yunjasper/ecse478_honours_thesis/0 Documentation/1 Design Calculations/non-inverting amplifier gain tolerance calculations.png

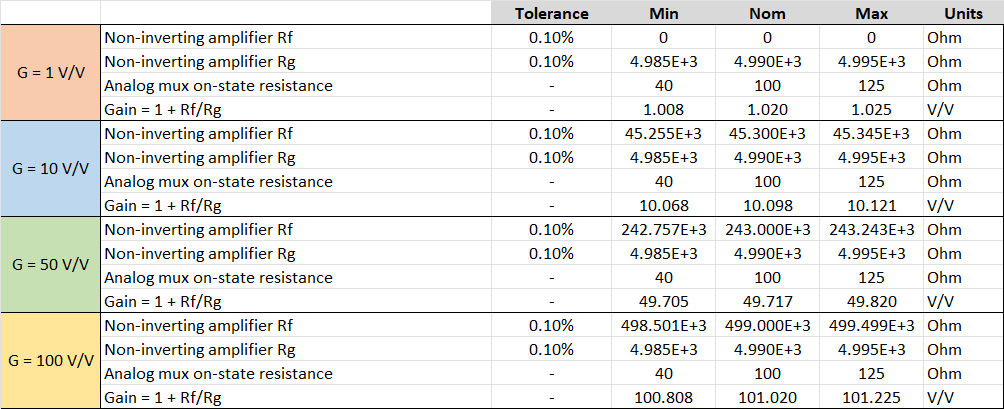
0 Documentation/1 Design Calculations/non-inverting amplifier gain tolerance calculations.png
