yunjasper/ecse478_honours_thesis/0 Documentation/2 Diagrams/Digital IO Protection.png

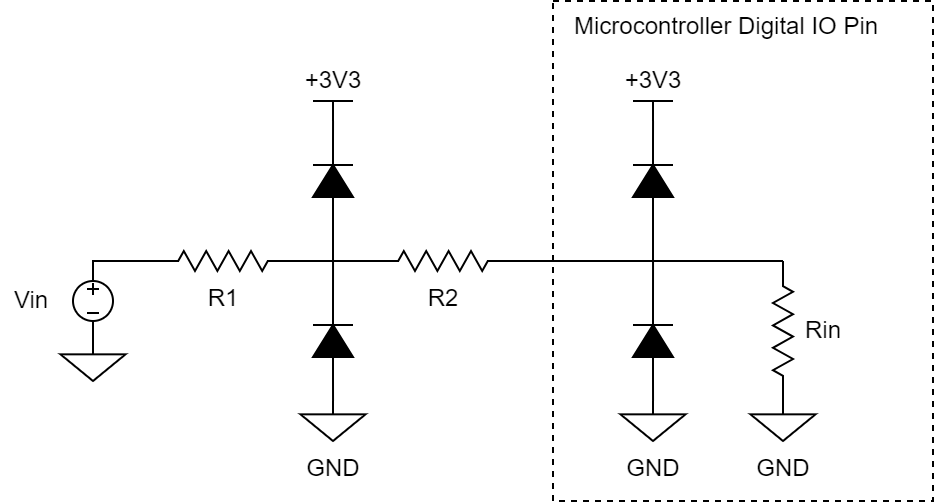
0 Documentation/2 Diagrams/Digital IO Protection.png
