yunjasper/ecse478_honours_thesis/0 Documentation/2 Diagrams/Main block diagram.png

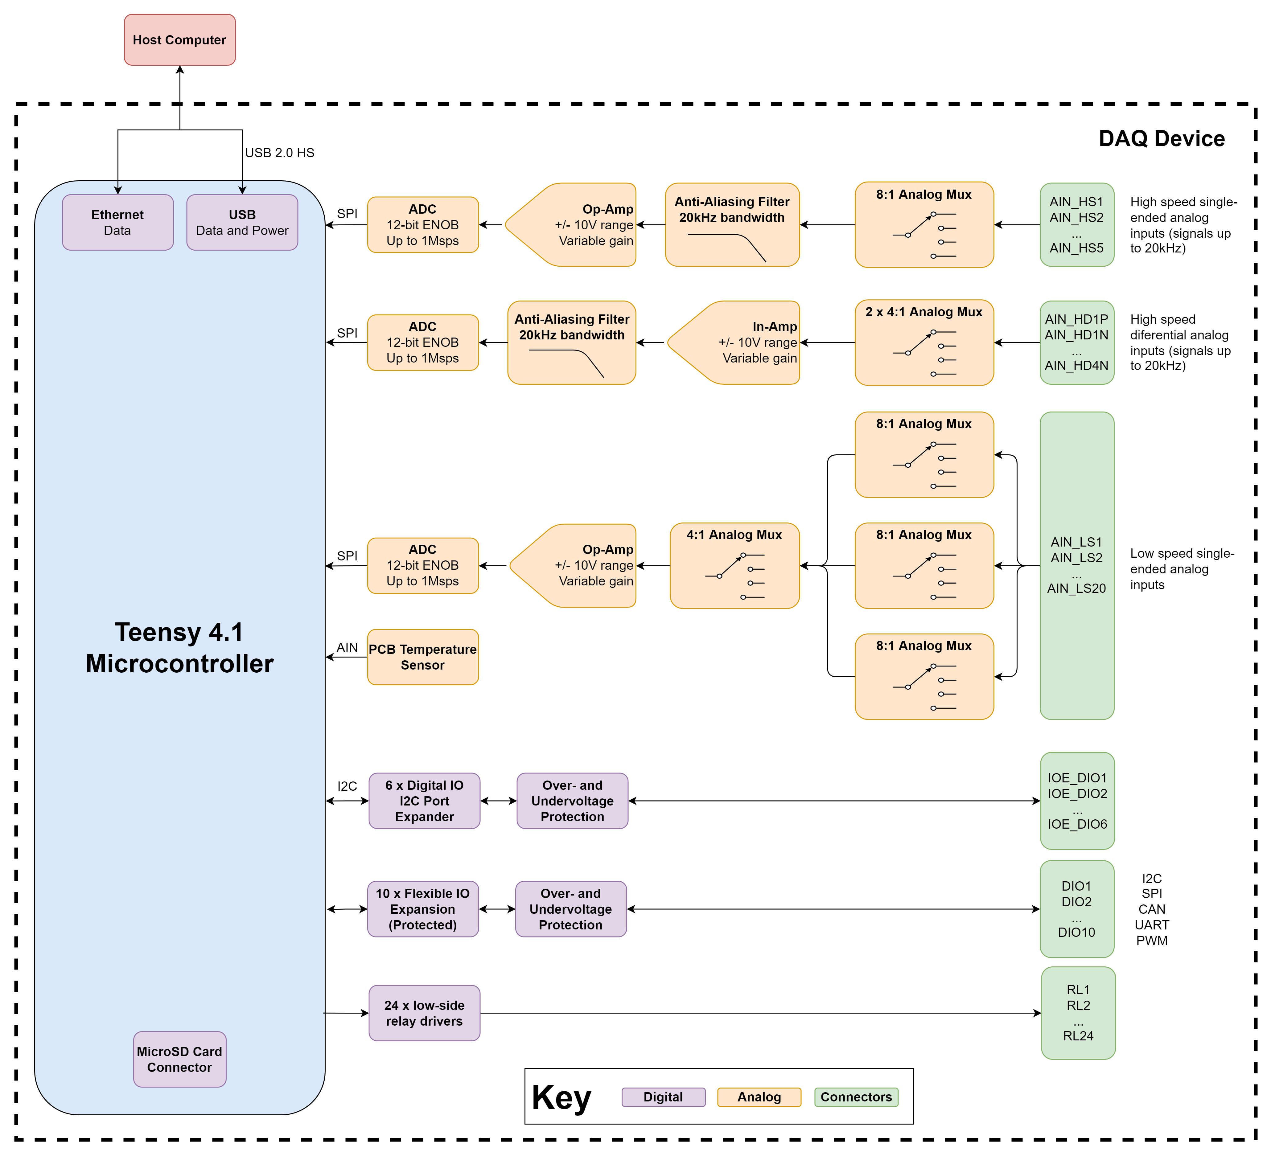
0 Documentation/2 Diagrams/Main block diagram.png
