yunjasper/ecse478_honours_thesis/0 Documentation/2 Diagrams/MCP33151 Eval Board Block Diagram.png

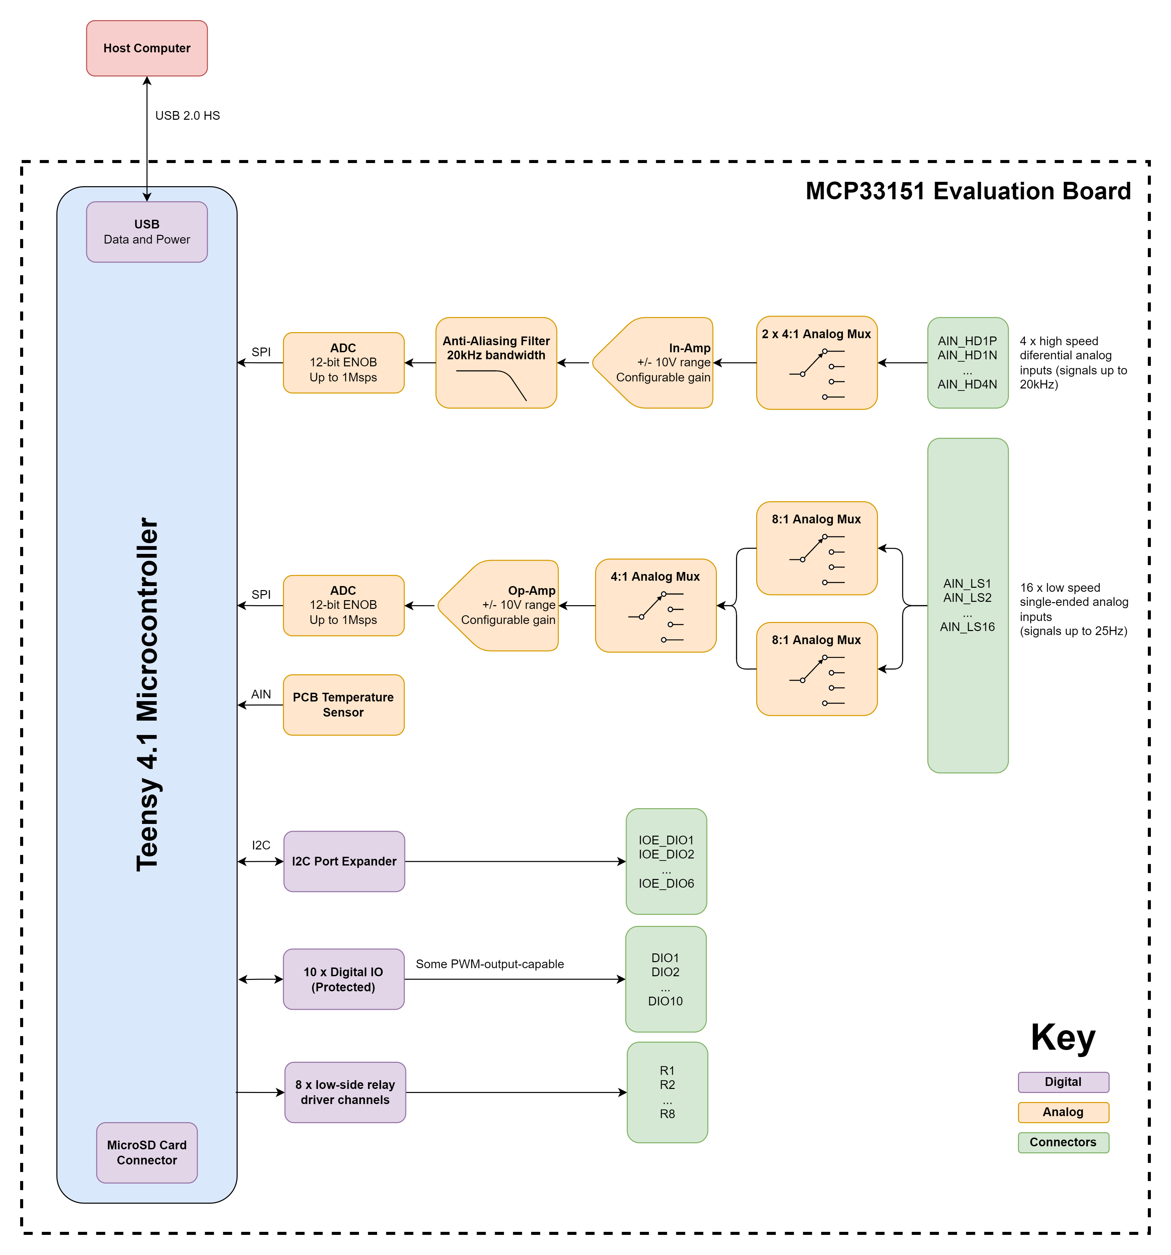
0 Documentation/2 Diagrams/MCP33151 Eval Board Block Diagram.png
