yunjasper/ecse478_honours_thesis/0 Documentation/2 Diagrams/Non-Inv Amp Gain Tolerances.png

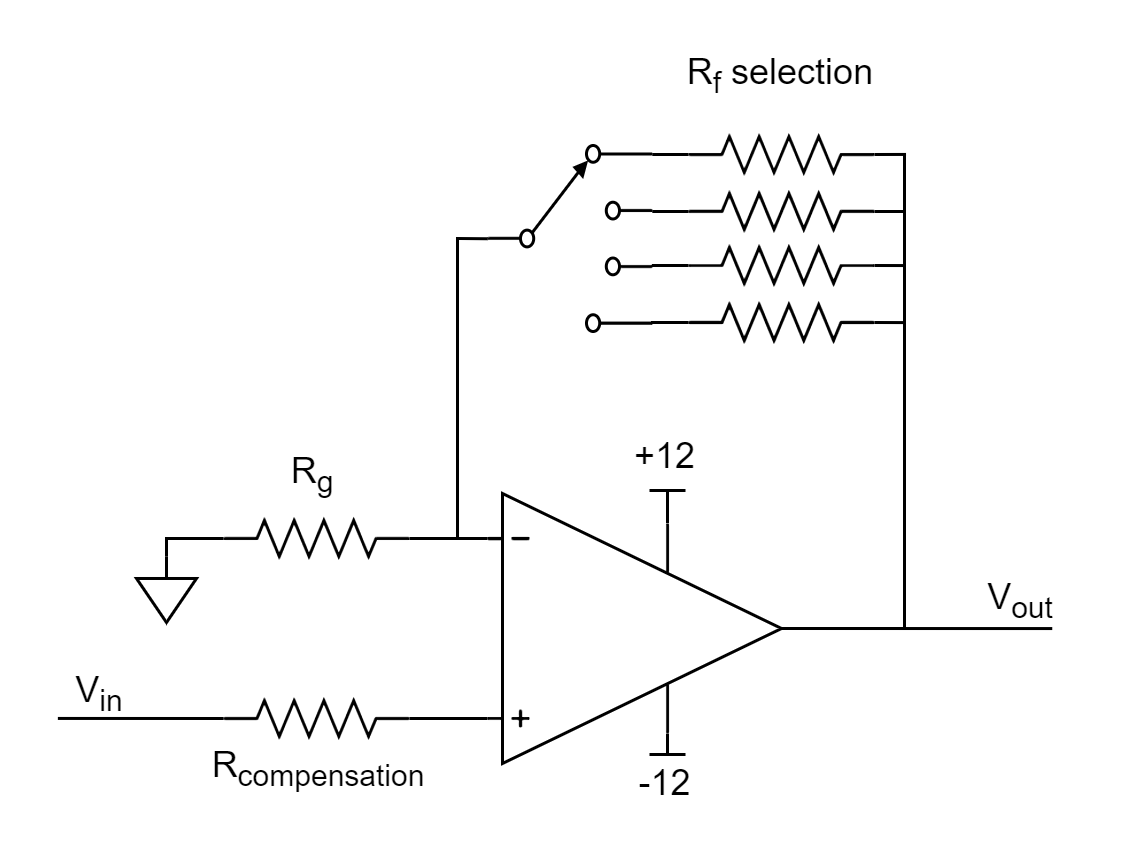
0 Documentation/2 Diagrams/Non-Inv Amp Gain Tolerances.png
