yunjasper/ecse478_honours_thesis/0 Documentation/2 Diagrams/Power Architecture.png

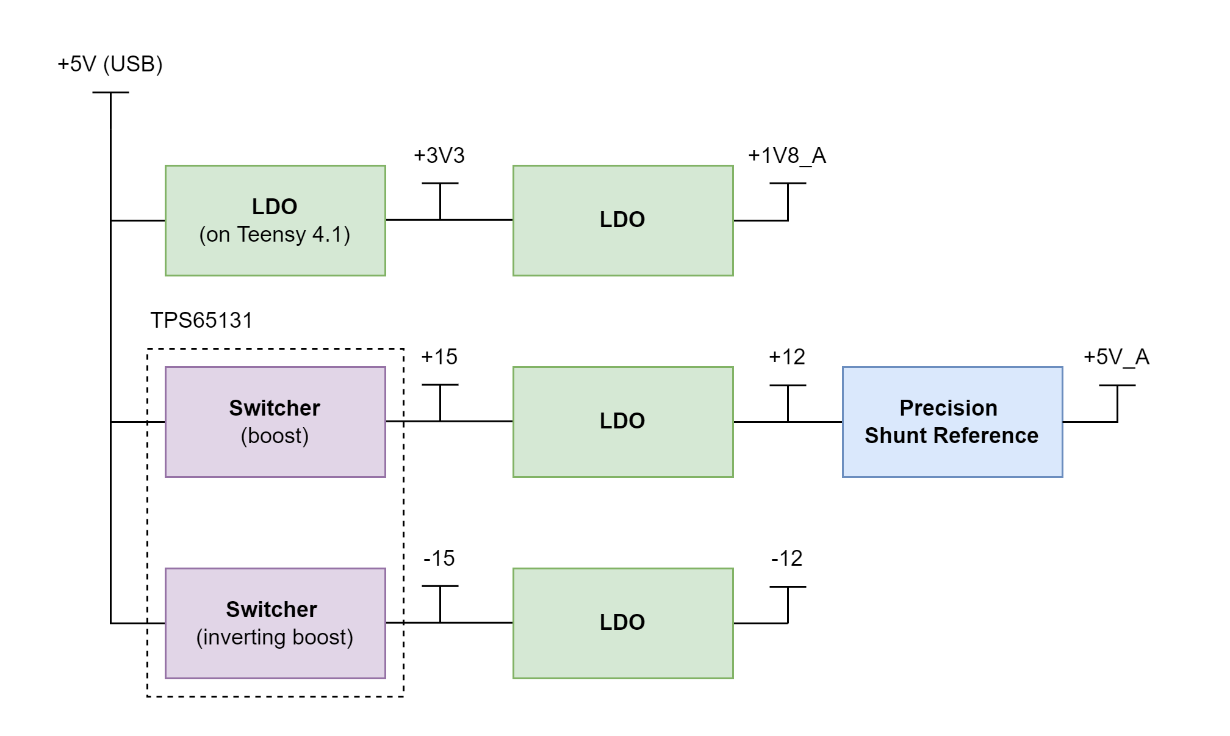
0 Documentation/2 Diagrams/Power Architecture.png
