yunjasper/ecse478_honours_thesis/0 Documentation/2 Diagrams/sampling and anti-aliasing.png

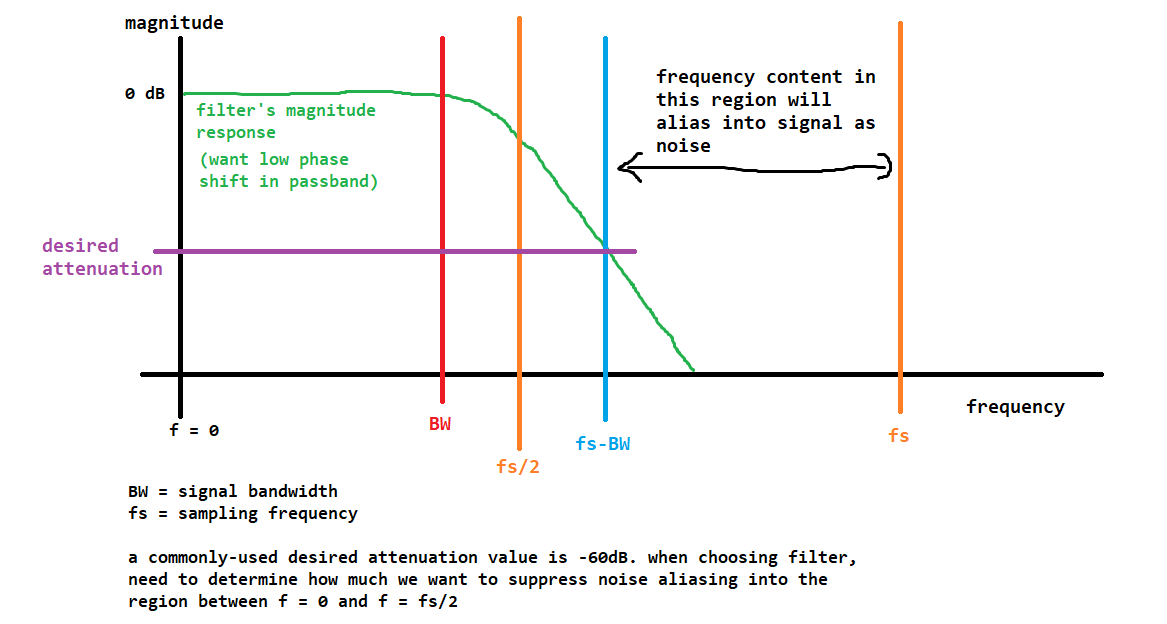
0 Documentation/2 Diagrams/sampling and anti-aliasing.png
