yunjasper/ecse478_honours_thesis/0 Documentation/2 Diagrams/sampling and anti-aliasing_original.png

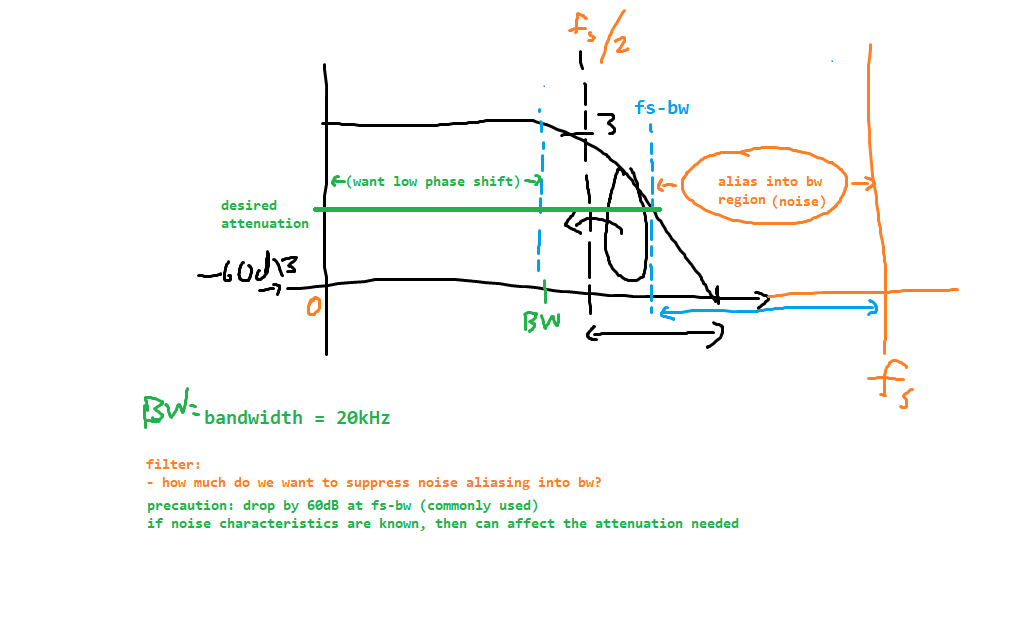
0 Documentation/2 Diagrams/sampling and anti-aliasing_original.png
