yunjasper/ecse478_honours_thesis/1 Hardware/MCP33151 Eval Board/Project Outputs for MCP33151 Eval Board/BOM - MCP33151 Eval Board.xlsx

Name | Description | Designator | Manufacturer Part Number 1 | Quantity (Single Board) | Quantity (3 boards)
10nF | Capacitor | C1, C17, C21 |  | 3 | 9
100nF | Capacitor | C2, C8, C11, C14, C15, C18, C24, C26, C27, C29, C30, C31, C32, C33, C34, C37, C38, C40, C41, C48, C49, C50, C51, C52, C53, C54, C55, C56, C57, C58, C59, C60, C61, C62, C63, C64, C65, C68, C69, C73, C74, C76, C77 |  | 43 | 129
47uF | Capacitor | C3, C4, C6, C19, C20, C78, C79 |  | 7 | 21
13pF | Capacitor | C5, C12 |  | 2 | 6
10uF | Capacitor | C7, C10, C13, C16, C66, C67, C70, C71, C72, C75 |  | 10 | 30
220nF | Capacitor | C9 |  | 1 | 3
4.7nF | Capacitor | C22 |  | 1 | 3
10uF | Capacitor | C23, C25, C28 |  | 3 | 9
100pF | Capacitor | C35, C39, C45, C46, C47 |  | 5 | 15
1nF | Capacitor | C36, C42, C43, C44 |  | 4 | 12
BAT54S | Rectifier Diode Small Signal Schottky 40V 0.3A 5ns 3-Pin SOT-23 T/R | D1, D2, D3, D4, D5, D6, D7, D8, D9, D10, D13, D14, D15, D16, D17, D18, D19, D20 | BAT54SFILM | 18 | 54
CDBA140-HF | Generic Schottky Diode | D11, D12 |  | 2 | 6
LED Green | Generic Green LED | D21, D22, D23, D24, D25, D26, D27, D29, D30 |  | 9 | 27
LED Red | Generic Red LED | D28 |  | 1 | 3
4.7uH | 4.7uH BWVS005050404R7M00 | L1, L2 |  | 2 | 6
1985195 | Header, 2-Pin | P1, P2, P3, P4, P5, P6, P7, P8, P9, P10, P11, P12, P13, P14, P15, P16, P17, P18, P19, P20, P21, P22, P23, P24, P25, P26, P27, P28, P29, P30, P34, P35, P36, P37 |  | 34 | 102
Jumper | Header, 2-Pin | P32, P33 |  | 2 | 6
AO3407A | AO3407A PMOS | Q1 |  | 1 | 3
470R |  | R1, R2, R5, R6, R9, R10, R13, R14, R17, R18, R33, R34, R37, R39, R41, R43 |  | 16 | 48
10R |  | R3, R4, R7, R8, R11, R12, R15, R16, R19, R20, R35, R36, R38, R40, R42, R44 |  | 16 | 48
10K0 | Resistor | R21, R27 |  | 2 | 6
536K0 | Resistor | R22 |  | 1 | 3
47K50 | Resistor | R23, R24 |  | 2 | 6
100R | Resistor | R25 |  | 1 | 3
576K00 | Resistor | R26 |  | 1 | 3
4K22 | Resistor | R28 |  | 1 | 3
33R | Resistor | R29, R101, R102, R103, R104, R105, R106 |  | 7 | 21
2K55 | Resistor | R30, R31, R77, R78, R79, R80 |  | 6 | 18
10K0 | Resistor | R32, R66, R67, R68, R69, R70, R91 |  | 7 | 21
0R | Resistor | R45, R47, R56, R61, R87, R88, R89, R90, R92 |  | 9 | 27
1K00 | Resistor | R46 |  | 1 | 3
47K5 | Resistor | R48, R49 |  | 2 | 6
63K40 | Resistor | R50 |  | 1 | 3
1K69 | Resistor | R51 |  | 1 | 3
48K70 | Resistor | R52 |  | 1 | 3
1K96 | Resistor | R53 |  | 1 | 3
24K30 | Resistor | R54 |  | 1 | 3
3K16 | Resistor | R55 |  | 1 | 3
4K99 | Resistor | R57, R62 |  | 2 | 6
45K30 | Resistor | R58, R63 |  | 2 | 6
243K00 | Resistor | R59, R64 |  | 2 | 6
499K00 | Resistor | R60, R65 |  | 2 | 6
10K0 | Resistor | R71, R72, R73, R74 |  | 4 | 12
4K70 | Resistor | R75, R76 |  | 2 | 6
200R | Resistor | R81 |  | 1 | 3
15R | Resistor | R82, R83 |  | 2 | 6
0R | Resistor | R84 |  | 1 | 3
4K53 | Resistor | R85, R86 |  | 2 | 6
Test Point | Keystone 5015 Test point | TP1, TP8, TP9, TP10, TP12, TP14, TP15, TP17, TP18, TP22, TP23, TP25, TP26, TP31, TP32, TP33, TP34, TP37, TP38 |  | 19 | 57
NUD3160DMT1G | IC INDCT LOAD DRVR INDUST SC74-6 | U1, U2, U3, U4 | NUD3160DMT1G | 4 | 12
TPS65131RGER | IC REG BUCK BST INV ADJ DL 24QFN | U5 | TPS65131RGER | 1 | 3
TLV74118PDBVR | None | U6 | TLV74118PDBVR | 1 | 3
ADR5045BRTZ-REEL7 | Precision Micropower Shunt Mode Voltage Reference, 5 V Output, Industrial, 3-pin SOT23 (RT-3), Reel | U7 | ADR5045BRTZ-REEL7 | 1 | 3
MC79L12ACDR | Fixed Regulator with -14.5 to -27 V Input and -12 V Output, 0 to 125 degC, 8-Pin SOIC (D), Green (RoHS & no Sb/Br) | U8 | MC79L12ACDR | 1 | 3
TLV76012DBZR | IC REG LINEAR 12V 100MA SOT23-3 | U9 | TLV76012DBZR | 1 | 3
Teensy 4.1 | Teensy 4.1 breakout (no ethernet or USB host pins exposed) | U10 |  | 1 | 3
MCP23008-E/ML | 8-Bit I/O Expander with Serial Interface, 20-Pin QFN, Extended Temperature | U11, U12 | MCP23008-E/ML | 2 | 6
INA821IDR | IC INST AMP 1 CIRCUIT 8SOIC | U13 | INA821IDR | 1 | 3
DG409DQ-E3 | DG409 Series 20 V 8-Ch/Dual 4-Ch High-Performance CMOS Analog Multiplexer | U14, U18, U20, U23 | DG409DQ-E3 | 4 | 12
RC4580 | 2-channel, 12-MHz, low-noise, low-distortion audio op amp with high output current 8-SOIC -40 to 85 | U15, U16, U17, U21 | RC4580IDR | 4 | 12
DG408DQ-T1-E3 | DG408DQ-T1-E3; Multiplexer Single 8: 1; 15 V; 18 V; 24 V; 28 V; 16-Pin TSSOP | U19, U22 | DG408DQ-T1-E3 | 2 | 6
MCP33151-10-E/MS | ADC 14-bit SAR 1Msps 10-MSOP | U24, U25 | MCP33151-10-E/MS | 2 | 6
MCP9700T-E/TT | Low-Power Linear Active Thermistor IC, 3-Pin SOT-23, Extended Temperature, Tape and Reel | U26 | MCP9700T-E/TT | 1 | 3
