yunjasper/ecse478_honours_thesis/1 Hardware/ECSE478 - DAQ Device/Project Outputs for ECSE478 - DAQ Device/BOM/Bill of Materials-ECSE478 - DAQ Device.xlsx

Bill of Materials -- DAQ Device
Name | Description | Designator | Quantity | Footprint
TLV2172IDR | 2-channel, 12-MHz, low-noise, low-distortion audio op amp with high output current 8-SOIC -40 to 85 | U24, U26, U27, U31, U32, U33, U37, U44 | 8 | SOIC-8
4.7uH | 4.7uH BWVS005050404R7M00 | L1, L2 | 2 | Inductor BWVS005050403R3M00
MCP23008-E/ML | 8-Bit I/O Expander with Serial Interface, 20-Pin QFN, Extended Temperature | U20, U21, U22, U23 | 4 | QFN-ML20_M
LDK320AM120R | 200 mA low quiescent current and high PSRR voltage regulator | U17 | 1 | SOT23-5
MCP33151-10-E/MS | ADC 14-bit SAR 1Msps 10-MSOP | U41, U42, U43 | 3 | MSOP-10
D12V0L1B2LP-7B | Bidirectional Zener diode | D33, D34, D35, D36, D37, D38, D39, D40, D41, D42, D43, D44, D45, D46, D47, D48, D49, D50, D51, D52, D53, D54, D55, D56, D57, D58, D59, D60, D61, D62, D63, D64, D65, D66, D67, D68, D69, D70, D71, D72, D73, D74, D75, D76 | 44 | DFN1006-2
100nF | Capacitor | C1, C2, C9, C12, C15, C16, C18, C19, C26, C28, C29, C31, C32, C34, C35, C36, C37, C38, C39, C43, C47, C48, C49, C50, C51, C52, C53, C55, C56, C57, C60, C61, C63, C64, C71, C72, C73, C74, C75, C77, C78, C80, C81, C82, C83, C84, C85, C86, C87, C88, C89, C90, C93, C94, C96, C98, C99, C103, C104, C108, C110, C113, C114 | 63 | 0402 CAP
22uF | Capacitor | C3, C4, C5, C20, C21, C22 | 6 | 1206 CAP
13pF | Capacitor | C6, C13 | 2 | 0402 CAP
47uF | Capacitor | C7, C111, C112 | 3 | 0805 CAP
10uF | Capacitor | C8, C11, C14, C17, C91, C92, C95, C97, C100, C101, C102, C105, C109 | 13 | 0603 CAP SAMSUNG CL10C
220nF | Capacitor | C10 | 1 | 0402 CAP
10nF | Capacitor | C23 | 1 | 0402 CAP
4.7nF | Capacitor | C24 | 1 | 0402 CAP
10uF | Capacitor | C25, C27, C30, C106, C107 | 5 | 0805 CAP
1nF | Capacitor | C40, C41, C42, C65, C66, C67 | 6 | 0402 CAP
100pF | Capacitor | C44, C45, C46, C68, C69, C70 | 6 | 0402 CAP
SMT-0540-T-9-R | CMT-9648-85T Magnetic buzzer | LS1 | 1 | Buzzer SMT-0540-T-9-R
LD25S24A4GV00LF | DB25 LD25S24A4GV00LF (Amphenol ICC) | J2, J4 | 2 | Connector DB25 Vertical LD25S24A4GV00LF
LD37S24A4GV00LF | DB37 LD37S24A4GV00LF (Amphenol ICC) | J1, J3 | 2 | Connector DB37 Vertical LD37S24A4GV00LF
DG408DQ-T1-E3 | DG408DQ-T1-E3; Multiplexer Single 8: 1; 15 V; 18 V; 24 V; 28 V; 16-Pin TSSOP | U25, U35, U38, U40 | 4 | TSSOP-16
DG409DQ-E3 | DG409 Series 20 V 8-Ch/Dual 4-Ch High-Performance CMOS Analog Multiplexer | U28, U30, U34, U36, U39 | 5 | TSSOP-16
MC79L12ACDR | Fixed Regulator with -14.5 to -27 V Input and -12 V Output, 0 to 125 degC, 8-Pin SOIC (D), Green (RoHS & no Sb/Br) | U16 | 1 | D0008A_M
LED Green | Generic Green LED | D19, D20, D21, D22, D23, D25, D30, D31, D32 | 9 | 0603 LED
LED Red | Generic Red LED | D24 | 1 | 0603 LED
220R | Generic resistor | R124 | 1 | 0402 RES
CDBA140-HF | Generic Schottky Diode | D1, D2 | 2 | Diode SMA
B0540WSHE3-TP | Generic Schottky Diode | D29 | 1 | Diode SOD323-F
1985195 | Header, 2-Pin | P1, P2, P3, P4, P5, P6, P7, P8, P9, P10, P11, P12, P13, P14, P15, P16, P17, P18, P19, P20, P21, P22, P23, P24, P25, P26, P27, P28, P29, P30, P31, P32, P33, P34, P35, P36, P37, P38, P39, P40, P41, P42, P43, P44, P45, P46, P47, P48 | 48 | Terminal Block 1985195 2-pos 3.5mm pitch
Jumper | Header, 2-Pin | P49, P50, P51 | 3 | HDR1X2
NUD3160DMT1G | IC INDCT LOAD DRVR INDUST SC74-6 | U1, U2, U3, U4, U5, U6, U7, U8, U9, U10, U11, U12 | 12 | SOT23-6
INA821IDR | IC INST AMP 1 CIRCUIT 8SOIC | U29 | 1 | FP-D0008A-IPC_A
TPS65131RGER | IC REG BUCK BST INV ADJ DL 24QFN | U13 | 1 | VQFN-24
Test Point - Keystone 5015 | Keystone 5015 Test point | TP1, TP2, TP3, TP4, TP7, TP8, TP10, TP11, TP15, TP16, TP18, TP19, TP24, TP25, TP26, TP28, TP31, TP33, TP34, TP35, TP36, TP37, TP39, TP42, TP43, TP44, TP51, TP53, TP54, TP55, TP58 | 31 | Test Point Keystone 5015
MCP9700T-E/TT | Low-Power Linear Active Thermistor IC, 3-Pin SOT-23, Extended Temperature, Tape and Reel | U19 | 1 | SOT-23-TT3_M
TLV74118PDBVR | None | U14 | 1 | FP-DBV0005A-IPC_A
ADR5045BRTZ-REEL7 | Precision Micropower Shunt Mode Voltage Reference, 5 V Output, Industrial, 3-pin SOT23 (RT-3), Reel | U15 | 1 | ADI-RT-3_M
BAT54S | Rectifier Diode Small Signal Schottky 40V 0.3A 5ns 3-Pin SOT-23 T/R | D3, D4, D5, D6, D7, D8, D9, D10, D11, D12, D13, D14, D15, D16, D17, D18, D26, D27, D28 | 19 | SOT23-3
15R | Resistor | R1, R8 | 2 | 0805 RES
536K0 | Resistor | R3 | 1 | 0402 RES
47K50 | Resistor | R4, R5 | 2 | 0402 RES
100R | Resistor | R6, R148 | 2 | 0402 RES
576K00 | Resistor | R7 | 1 | 0402 RES
4K22 | Resistor | R10 | 1 | 0402 RES
0R | Resistor | R11, R18, R76, R78, R83, R86, R102, R105, R110, R111, R191, R192, R193, R194 | 14 | 0402 RES
33R | Resistor | R12, R13, R14, R15, R16, R17, R125, R126, R127, R128, R129, R130, R131, R132, R133, R134, R135, R136, R137, R138, R139, R140, R142, R143, R189 | 25 | 0402 RES
2K55 | Resistor | R19, R20 | 2 | 0402 RES
220R | Resistor | R21 | 1 | 0402 RES
10K0 | Resistor | R54, R55, R118, R119, R120, R121, R122, R123, R144, R146, R147, R190, R196, R197, R198, R199, R201, R203, R204, R205 | 20 | 0402 RES
4K70 | Resistor | R56, R57 | 2 | 0402 RES
1K00 | Resistor | R58, R59, R60, R145 | 4 | 0402 RES
1K69 | Resistor | R62, R69, R91, R97 | 4 | 0402 RES
63K40 | Resistor | R63, R70, R90, R96 | 4 | 0402 RES
1K96 | Resistor | R64, R71, R93, R99 | 4 | 0402 RES
48K70 | Resistor | R65, R72, R92, R98 | 4 | 0402 RES
3K16 | Resistor | R66, R73, R95, R101 | 4 | 0402 RES
24K30 | Resistor | R67, R74, R94, R100 | 4 | 0402 RES
2K20 | Resistor | R68, R85, R89, R149, R150, R151, R152, R153, R154, R155, R156, R157, R158, R159, R160, R161, R162, R163, R164, R165, R166, R167, R168, R169, R170, R171, R172, R173, R174, R175, R176, R177, R178, R179, R180, R181, R182, R183, R184, R185, R186, R187, R188, R200, R202 | 45 | 0402 RES
4K53 | Resistor | R77, R104, R113 | 3 | 0402 RES
4K99 | Resistor | R79, R106, R114 | 3 | 0402 RES
45K30 | Resistor | R80, R107, R115 | 3 | 0402 RES
243K00 | Resistor | R81, R108, R116 | 3 | 0402 RES
499K00 | Resistor | R82, R109, R117 | 3 | 0402 RES
0R020 | Resistor | R195 | 1 | 0805 RES
470R | Resistor | R22, R23, R24, R25, R30, R31, R32, R36, R37, R38, R42, R43, R44, R48, R49, R50 | 16 | 0805 RES
10R | Resistor | R26, R27, R28, R29, R33, R34, R35, R39, R40, R41, R45, R46, R47, R51, R52, R53 | 16 | 0603 RES
Teensy 4.1 | Teensy 4.1 | U18 | 1 | Teensy 4.1
PTS060315V005 | Thermal Fuse | F1 | 1 | Fuse Thermal 0603 PTS060315V005
