yunjasper/ecse478_honours_thesis/0 Documentation/Current Test Site DAQ Setup 2022-09-13.png

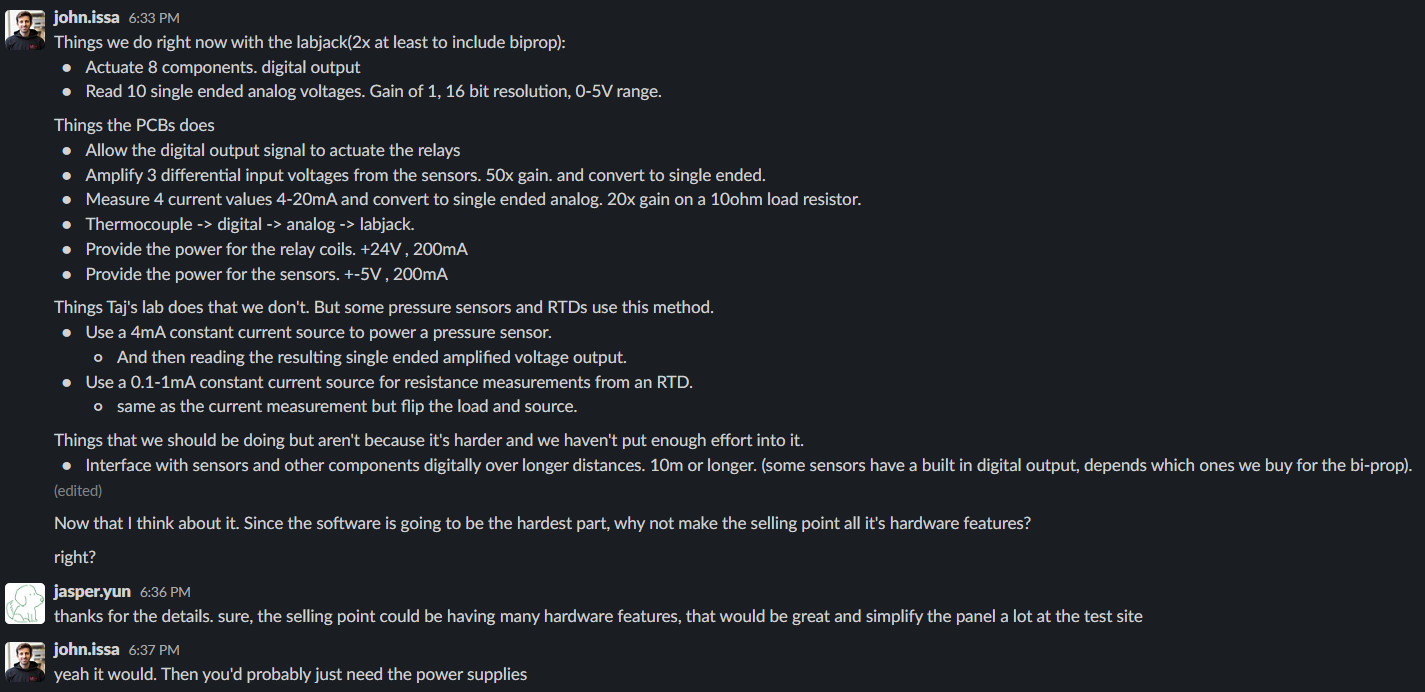
0 Documentation/Current Test Site DAQ Setup 2022-09-13.png
