yunjasper/ecse478_honours_thesis/1 Hardware/DAQ Device Board Bringup/DAQ device board bringup.xlsx

Sheet: Power rails
DAQ Device Power Rail Checking
Rail | Voltage (V) | Without Teensy on board, power from KORAD KA3005D
+15 | 14.533
-15 | -14.220
+12 | 11.958
-12 | -12.214
+5V_A | 4.985
1V8_A | -- Teensy not populated, no 3v3 available
current consumption: around 1.1A -- there must be a hardware problem somewhere
Hot components
U27
U37
fixed by changing 33r on output of gain stage to 10k because I don't have many 100R
repeat sans teensy after changing 33R to 10k
Rail | Voltage (V) | Ripple (mVpp) | Ripple Freq (kHz)
+15 | 14.485 | 76.8 | 22.73
-15 | -14.183 | 64.8 | 21.28
+12 | 11.969 | 6.8 | 21.28 | approx, hard to tell
-12 | -12.267 | 4.4 | n/a
+5V_A | 5.000 | 10.6 | 3.247 | approx, hard to tell
1V8_A | 1.8011 | 7 | n/a | measured after by adding Teensy so above measurements of rails may be invalid
current consumption: 0.201A |  |  |  | will need to redo test when power comes from USB because USB is noisier
with Teensy: current = 268mA (blinky program default)
5V usb | 5.112 | 146 | 22.73 | powered by xps13, with charger plugged in
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
