yunjasper/ecse478_honours_thesis/1 Hardware/MCP33151 Eval Board Bringup/Testing Data/Eval board bringup measurements.xlsx

Sheet: Power rails
Power Rail Measurements
with multimeter and hook probes
Rail | Voltage (V)
+15V rail | 14.885
-15V rail | -14.533
+12V rail | 11.909
-12V rail | -12.270
+5V (USB) | 5.066
+3V3 rail | 3.3189
+5V_A | 4.979
+1V8_A | 1.8027
with oscilloscope (settings below)
rail | ripple (mVpp) | ripple frequency (kHz) | oscilloscope screenshot filename
+15V rail | 224.00 | 20.41 | 25
-15V rail | 188.00 | 25 | 26, 27
+12V rail | 21.40 | n/a | 28
-12V rail | 12.80 | 25 | 29
+5V_A | 12.00 | n/a | 31
+1V8_A | 10.20 | n/a | 30
oscilloscope settings:
probe: 10x
bandwidth limited to 20M
rails loaded by board only (no external connections)
probe with ground spring
ac coupled
200MHz probe
probing the test points for the rails
board powered by phone charger brick
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
