yunjasper/ecse478_honours_thesis/1 Hardware/MCP33151 Eval Board Bringup/Oscilloscope Screenshots/-15V_rail.png

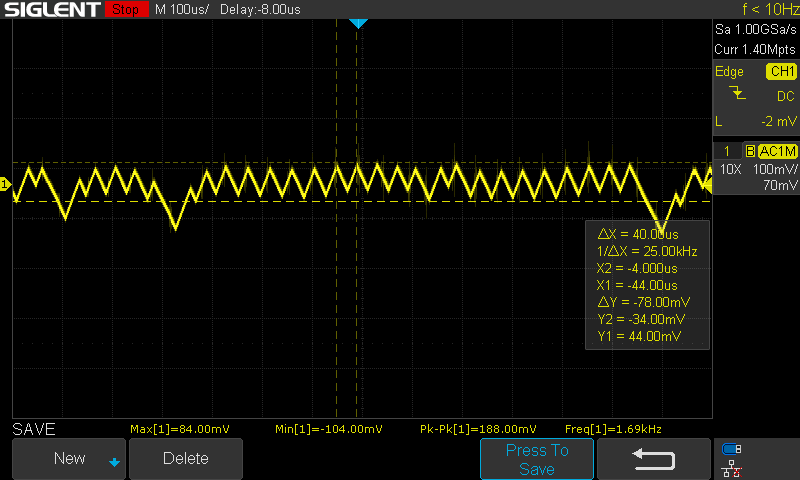
1 Hardware/MCP33151 Eval Board Bringup/Oscilloscope Screenshots/-15V_rail.png
