yunjasper/ecse478_honours_thesis/1 Hardware/MCP33151 Eval Board/Project Outputs for MCP33151 Eval Board/Schematics/SCH MCP33151 Eval Board.PDF

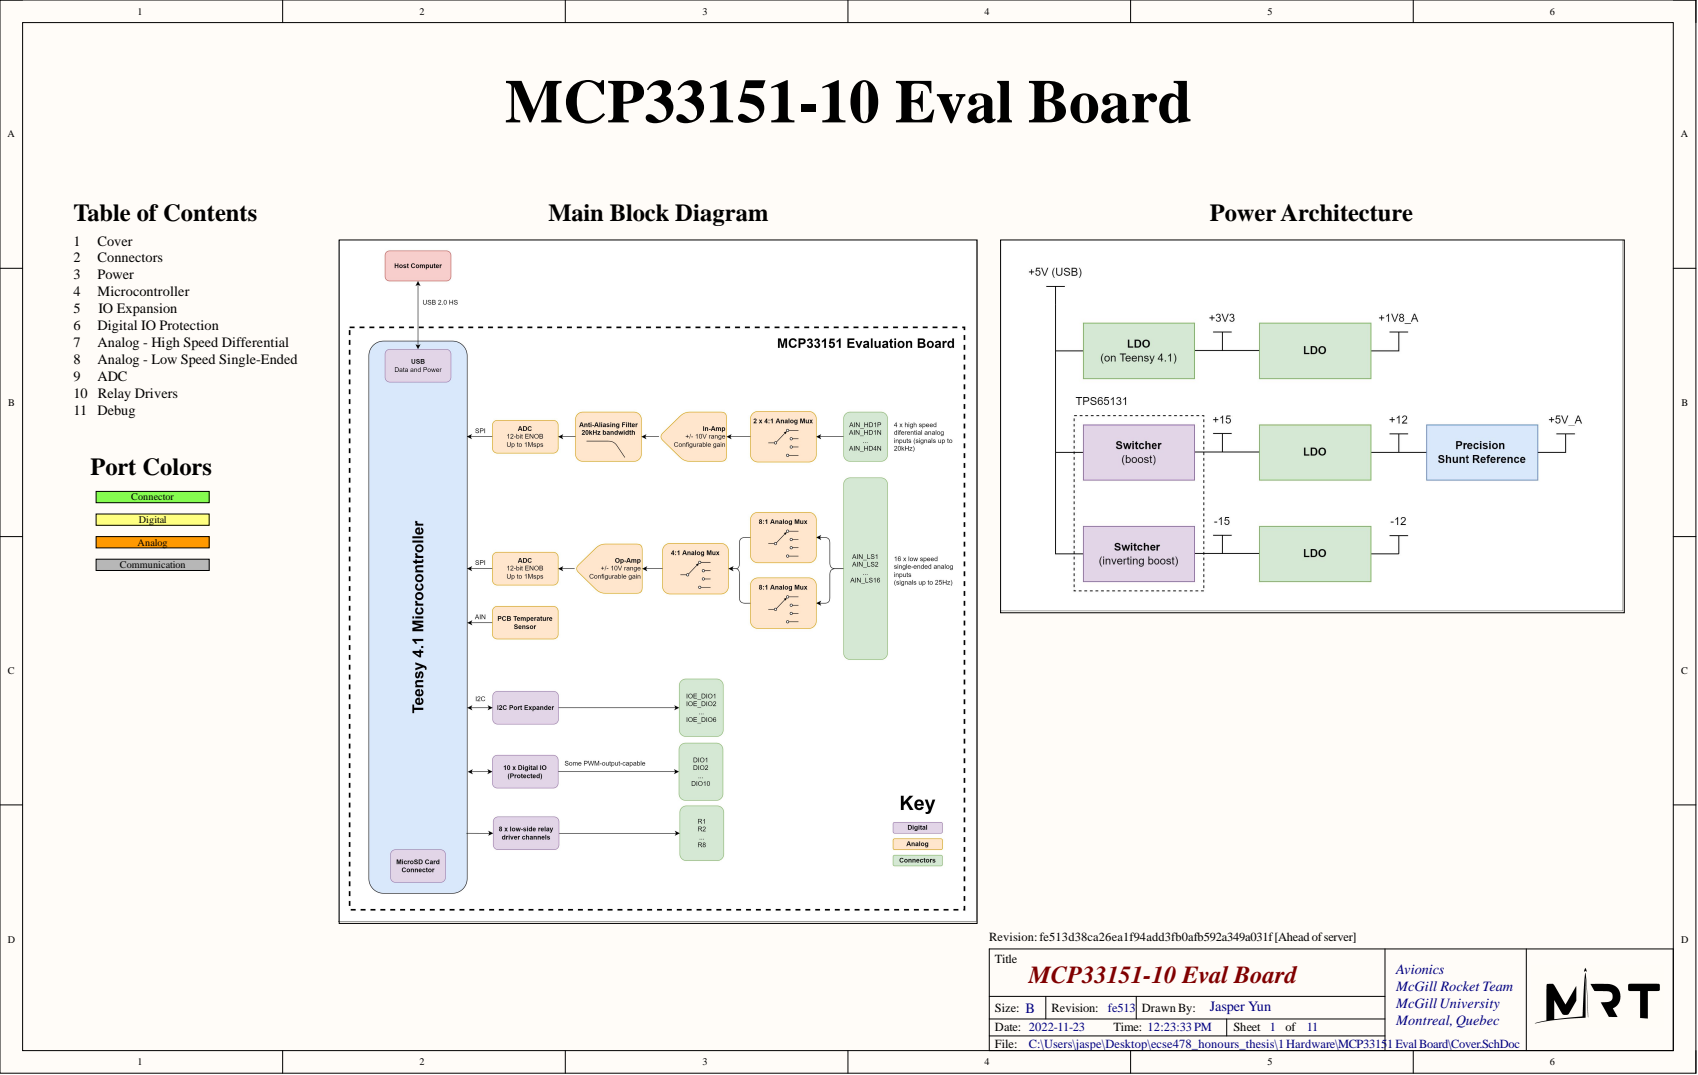
[picture p18: page 1]

Revision: fe513d38ca26ea1f94add3fb0afb592a349a031f [Ahead of server]

Title MCP33151-10 Eval Board | Avionics McGill Rocket Team McGill University

B Size: | Revision: fe513 | DrawnBy: Jasper Yun
Date: 2022-11-23 Time: 12:23:33 PM | Sheet of | Montreal, Quebec 11

File: C:\Users\jaspe\Desktop\ecse478_honours_thesis\1 Hardware\MCP33151 Eval Board\Cover.SchDoc

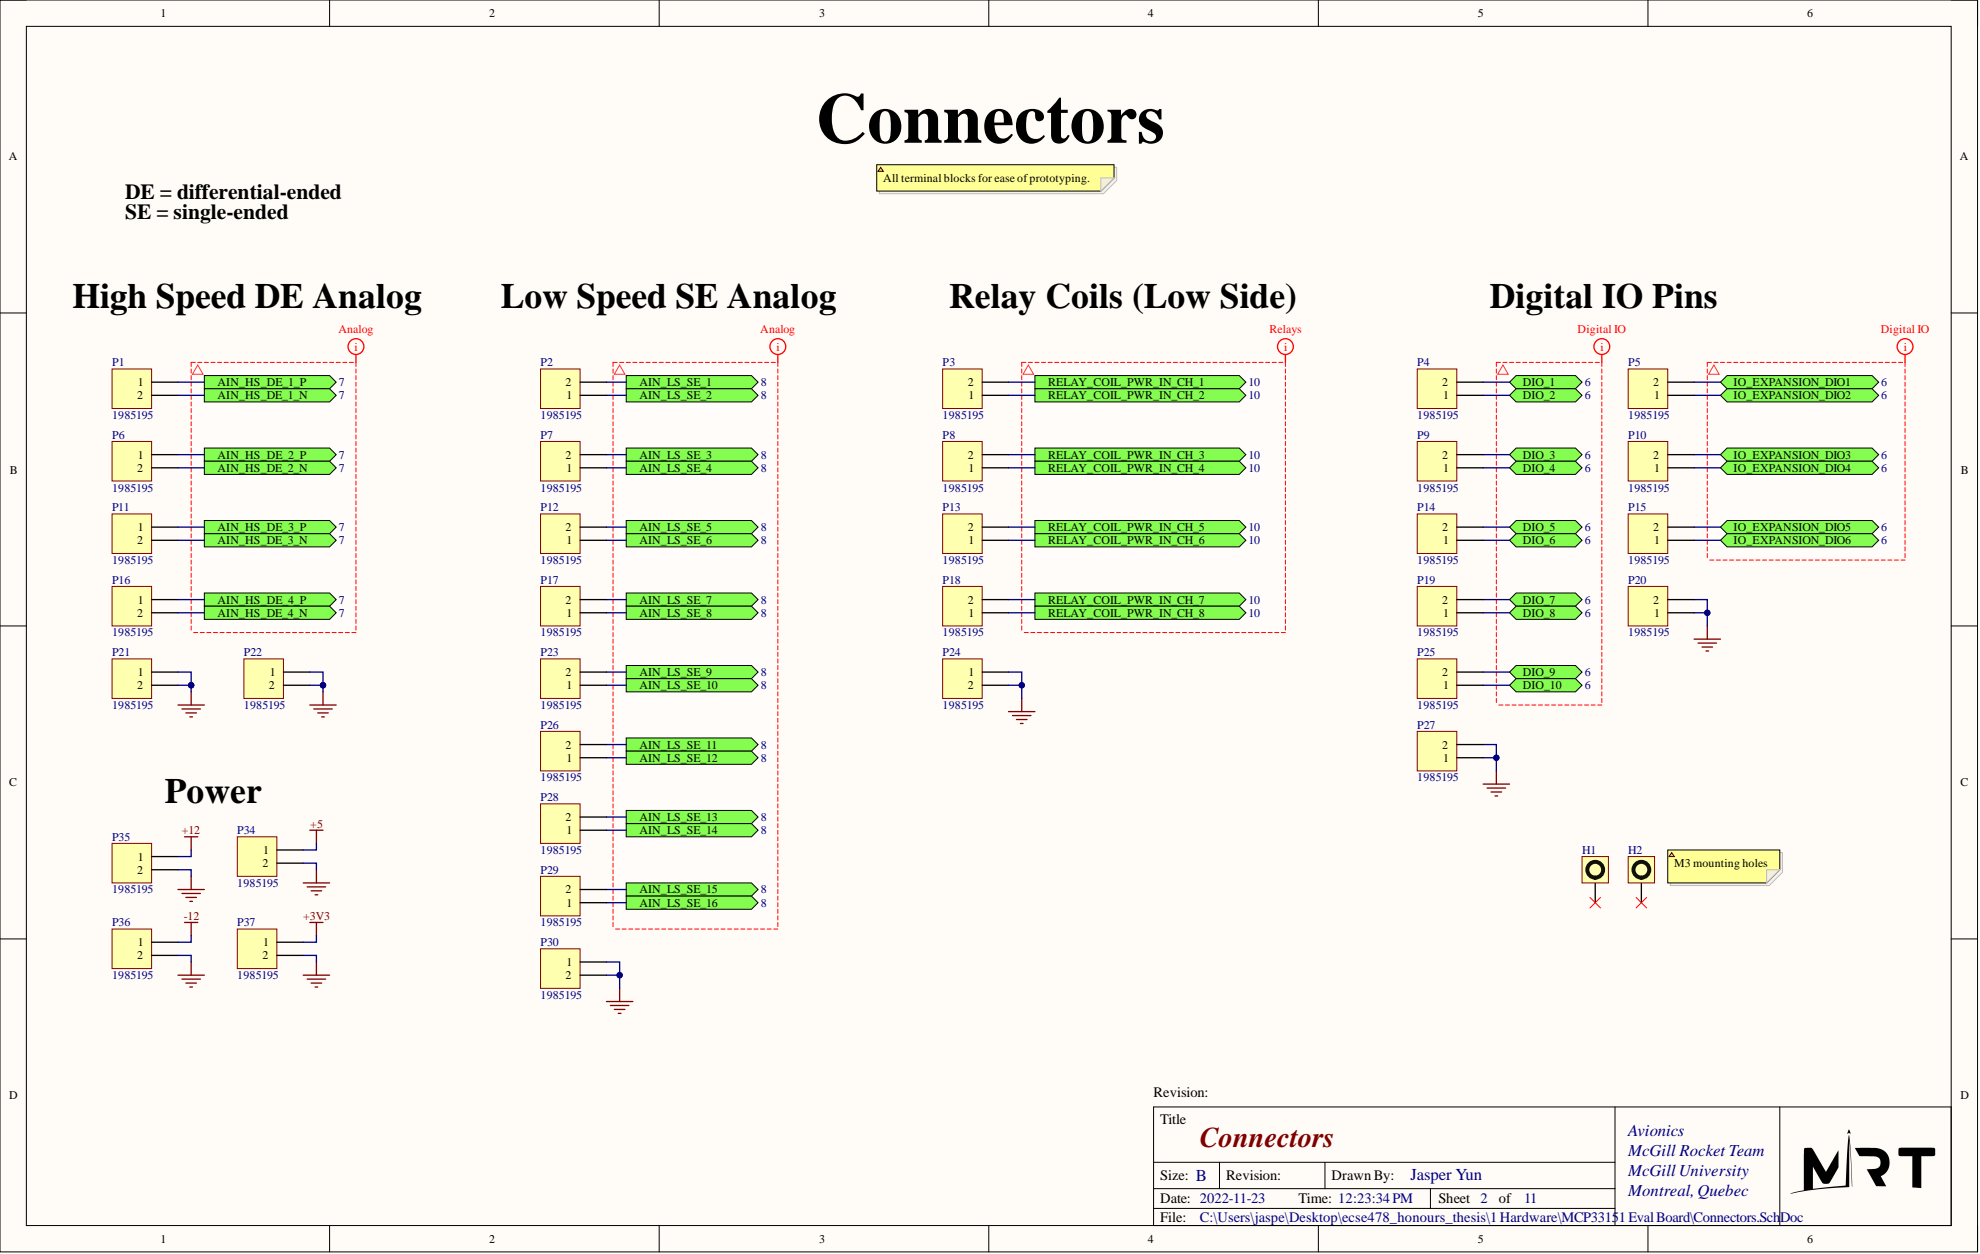
[picture p19: page 2]

All terminal blocks for ease of prototyping.

Relay Coils (Low Side)

File: C:\Users\jaspe\Desktop\ecse478_honours_thesis\1 Hardware\MCP33151 Eval Board\Connectors.SchDoc

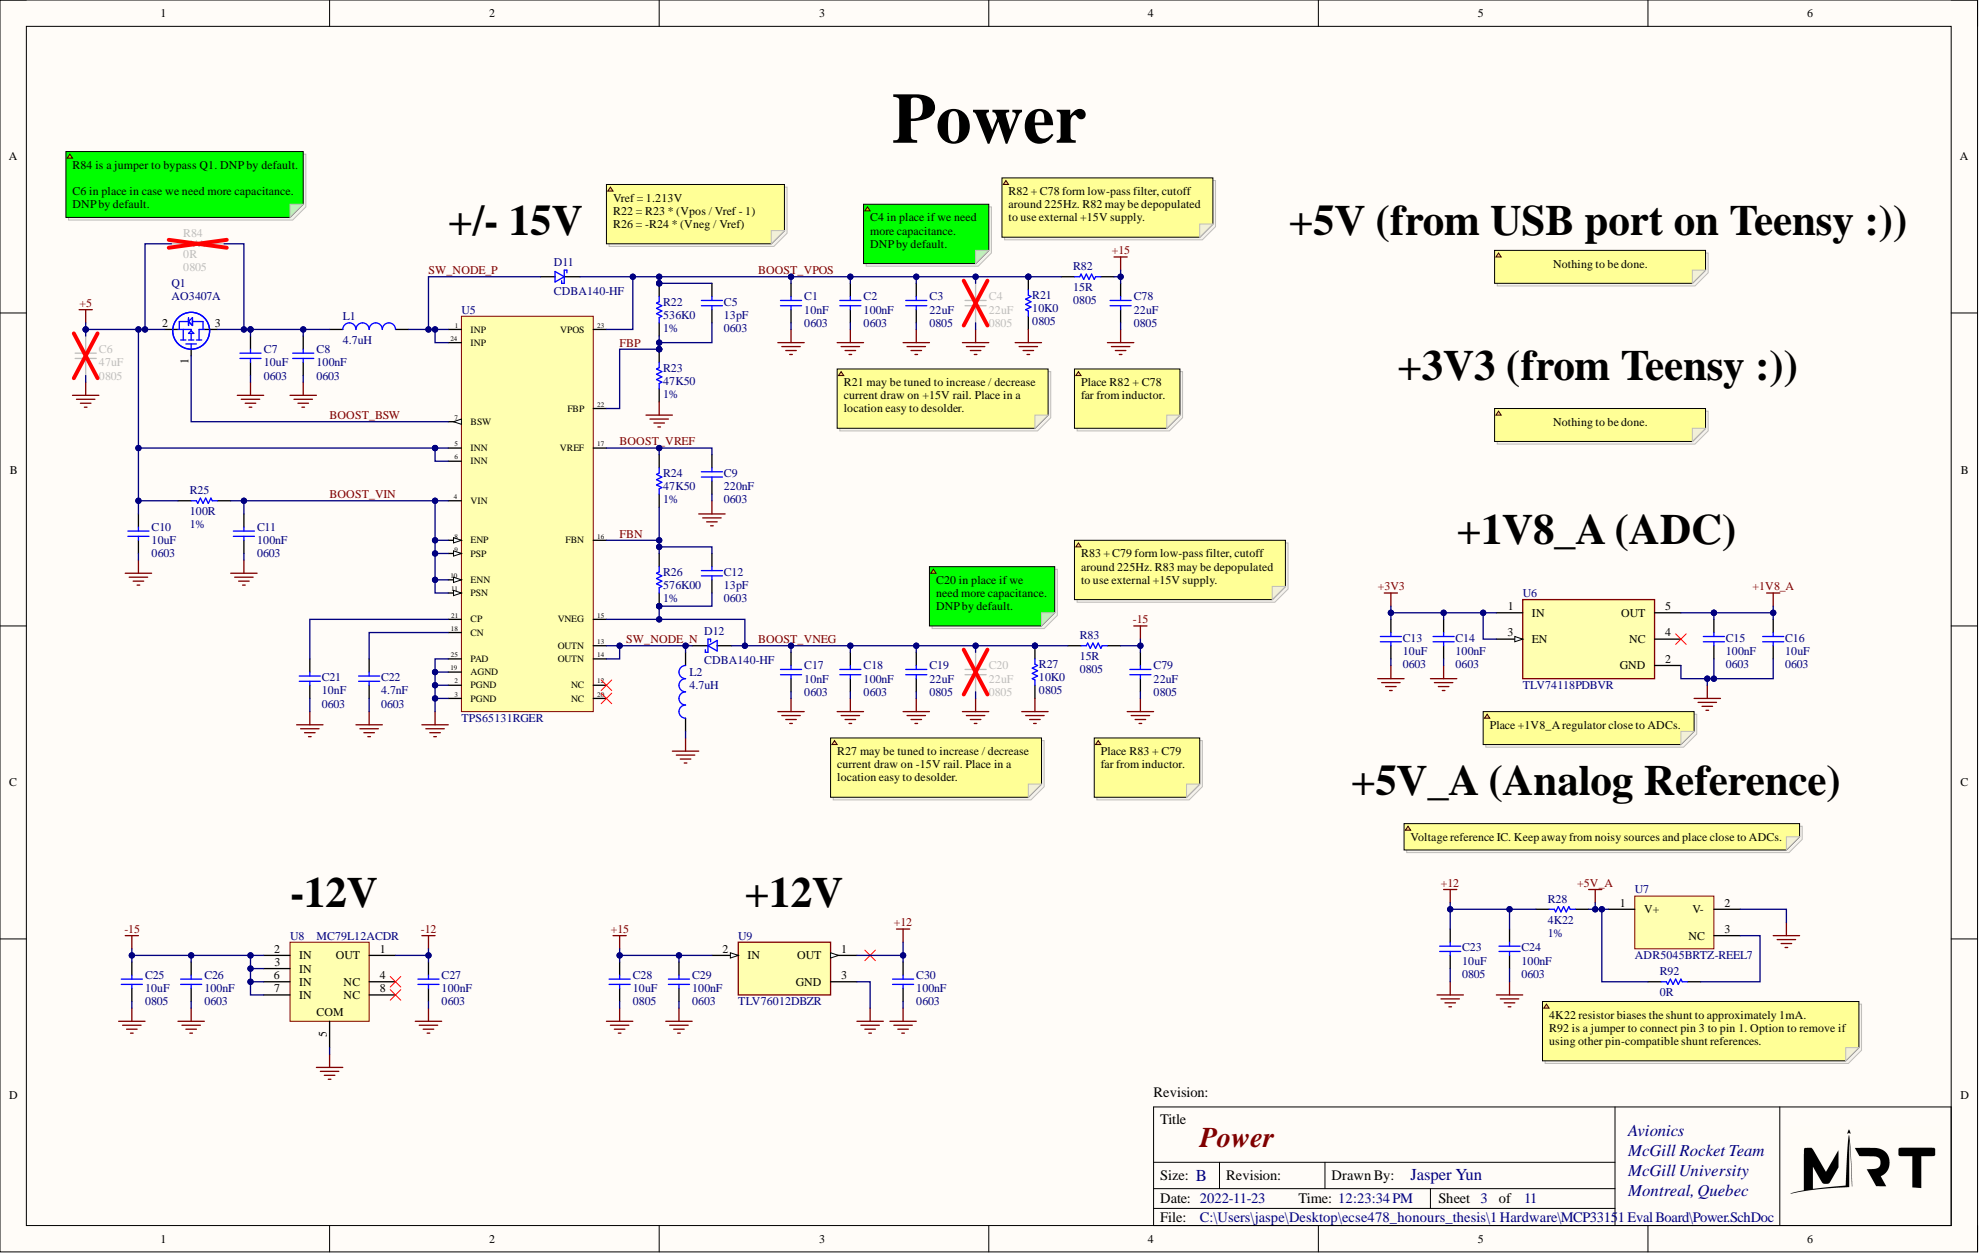
[picture p20: page 3]

R84 is a jumper to bypass Q1. DNP by default.

C6 in place in case we need more capacitance.
DNP by default.

R82 + C78 form low-pass filter, cutoff
around 225Hz. R82 may be depopulated
to use external +15V supply.

+5V (from USB port on Teensy :))

C4 in place if we need
more capacitance.

Nothing to be done.

R21 may be tuned to increase / decrease
current draw on +15V rail. Place in a
location easy to desolder.

R83 + C79 form low-pass filter, cutoff
around 225Hz. R83 may be depopulated

C20 in place if we
need more capacitance.

Place +1V8_A regulator close to ADCs.

R27 may be tuned to increase / decrease
current draw on -15V rail. Place in a

Voltage reference IC. Keep away from noisy sources and place close to ADCs.

4K22 resistor biases the shunt to approximately 1mA.
R92 is a jumper to connect pin 3 to pin 1. Option to remove if
using other pin-compatible shunt references.

File: C:\Users\jaspe\Desktop\ecse478_honours_thesis\1 Hardware\MCP33151 Eval Board\Power.SchDoc

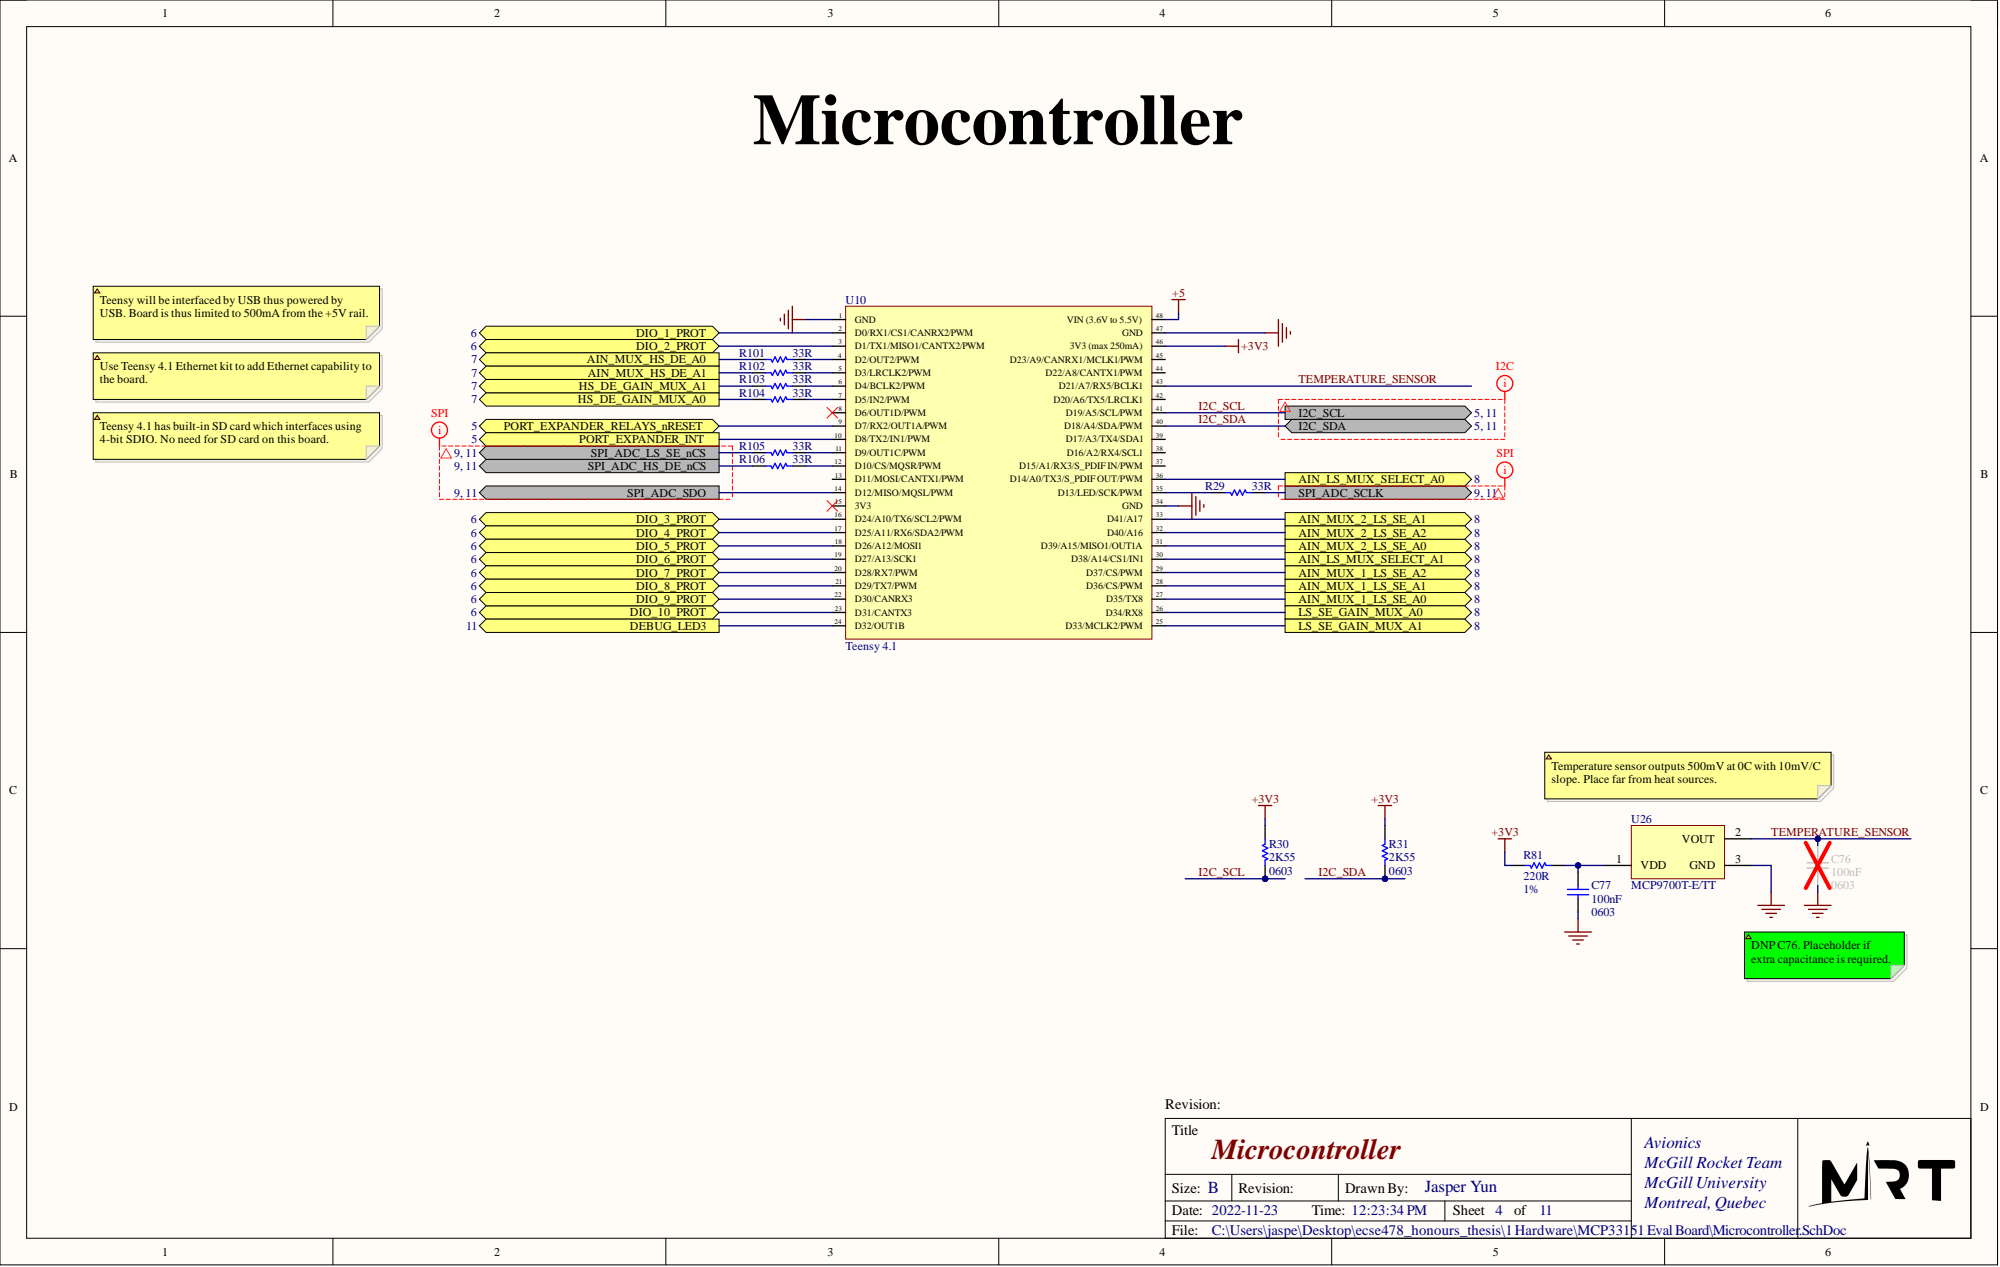
[picture p21: page 4]

Teensy will be interfaced by USB thus powered by
USB. Board is thus limited to 500mA from the +5V rail.

Use Teensy 4.1 Ethernet kit to add Ethernet capability to
the board.

Teensy 4.1 has built-in SD card which interfaces using
4-bit SDIO. No need for SD card on this board.

Temperature sensor outputs 500mV at 0C with 10mV/C
slope. Place far from heat sources.

DNPC76. Placeholder if
extra capacitance is required.

File: C:\Users\jaspe\Desktop\ecse478_honours_thesis\1 Hardware\MCP33151 Eval Board\Microcontroller.SchDoc

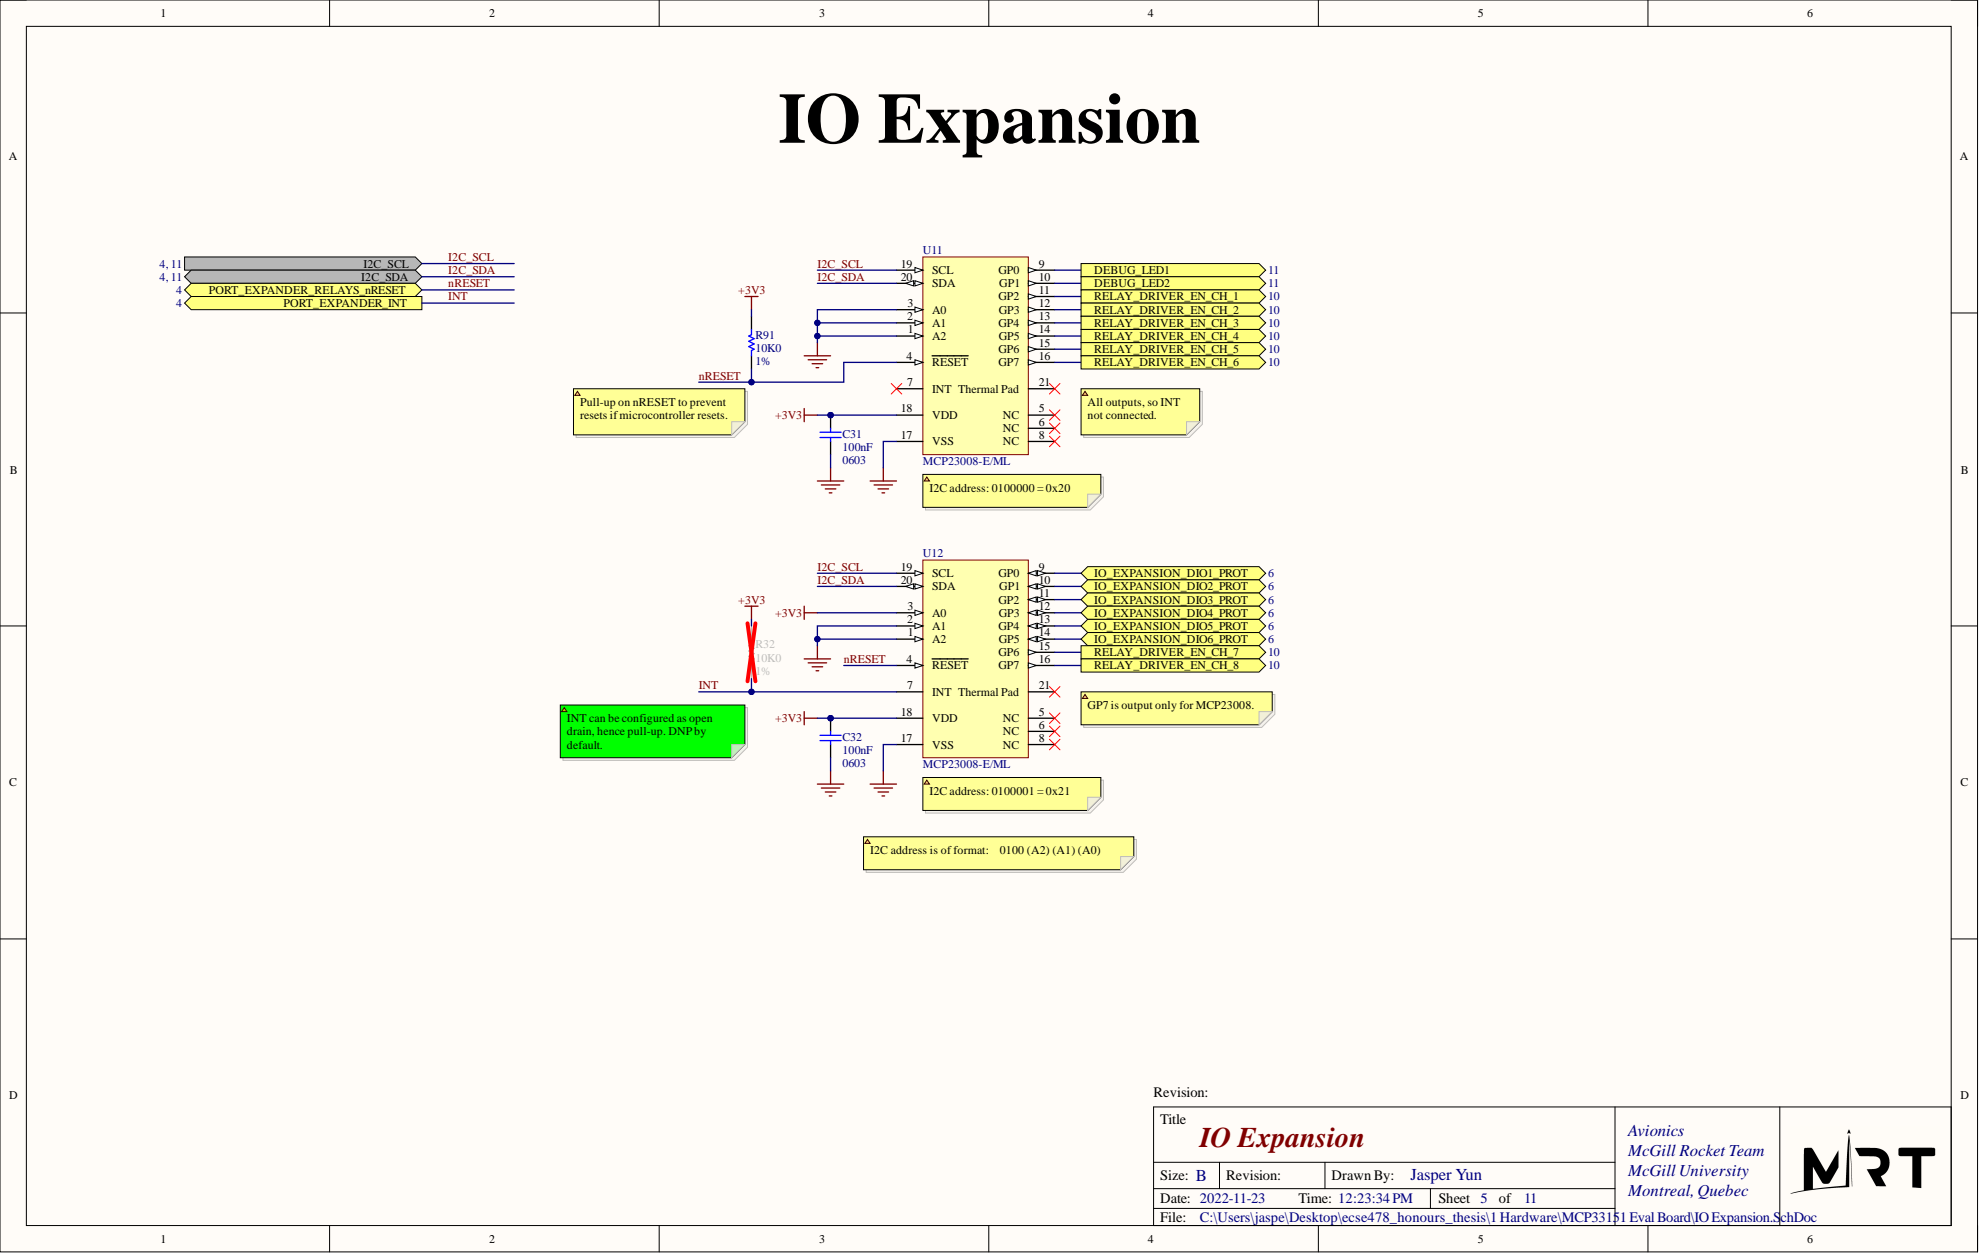
[picture p22: page 5]

Titl e | Avioni c s McG i l l Rocket Team McG i l l Universi ty Mont real , Quebec Ev al B o ard\IO Ex p an s i o n . S | c h D o c

Siz e : B | Re visi o n : | : Jasper Yun DrawnBy
Da te : Tim e : 3:3 PM | S h e e t o f

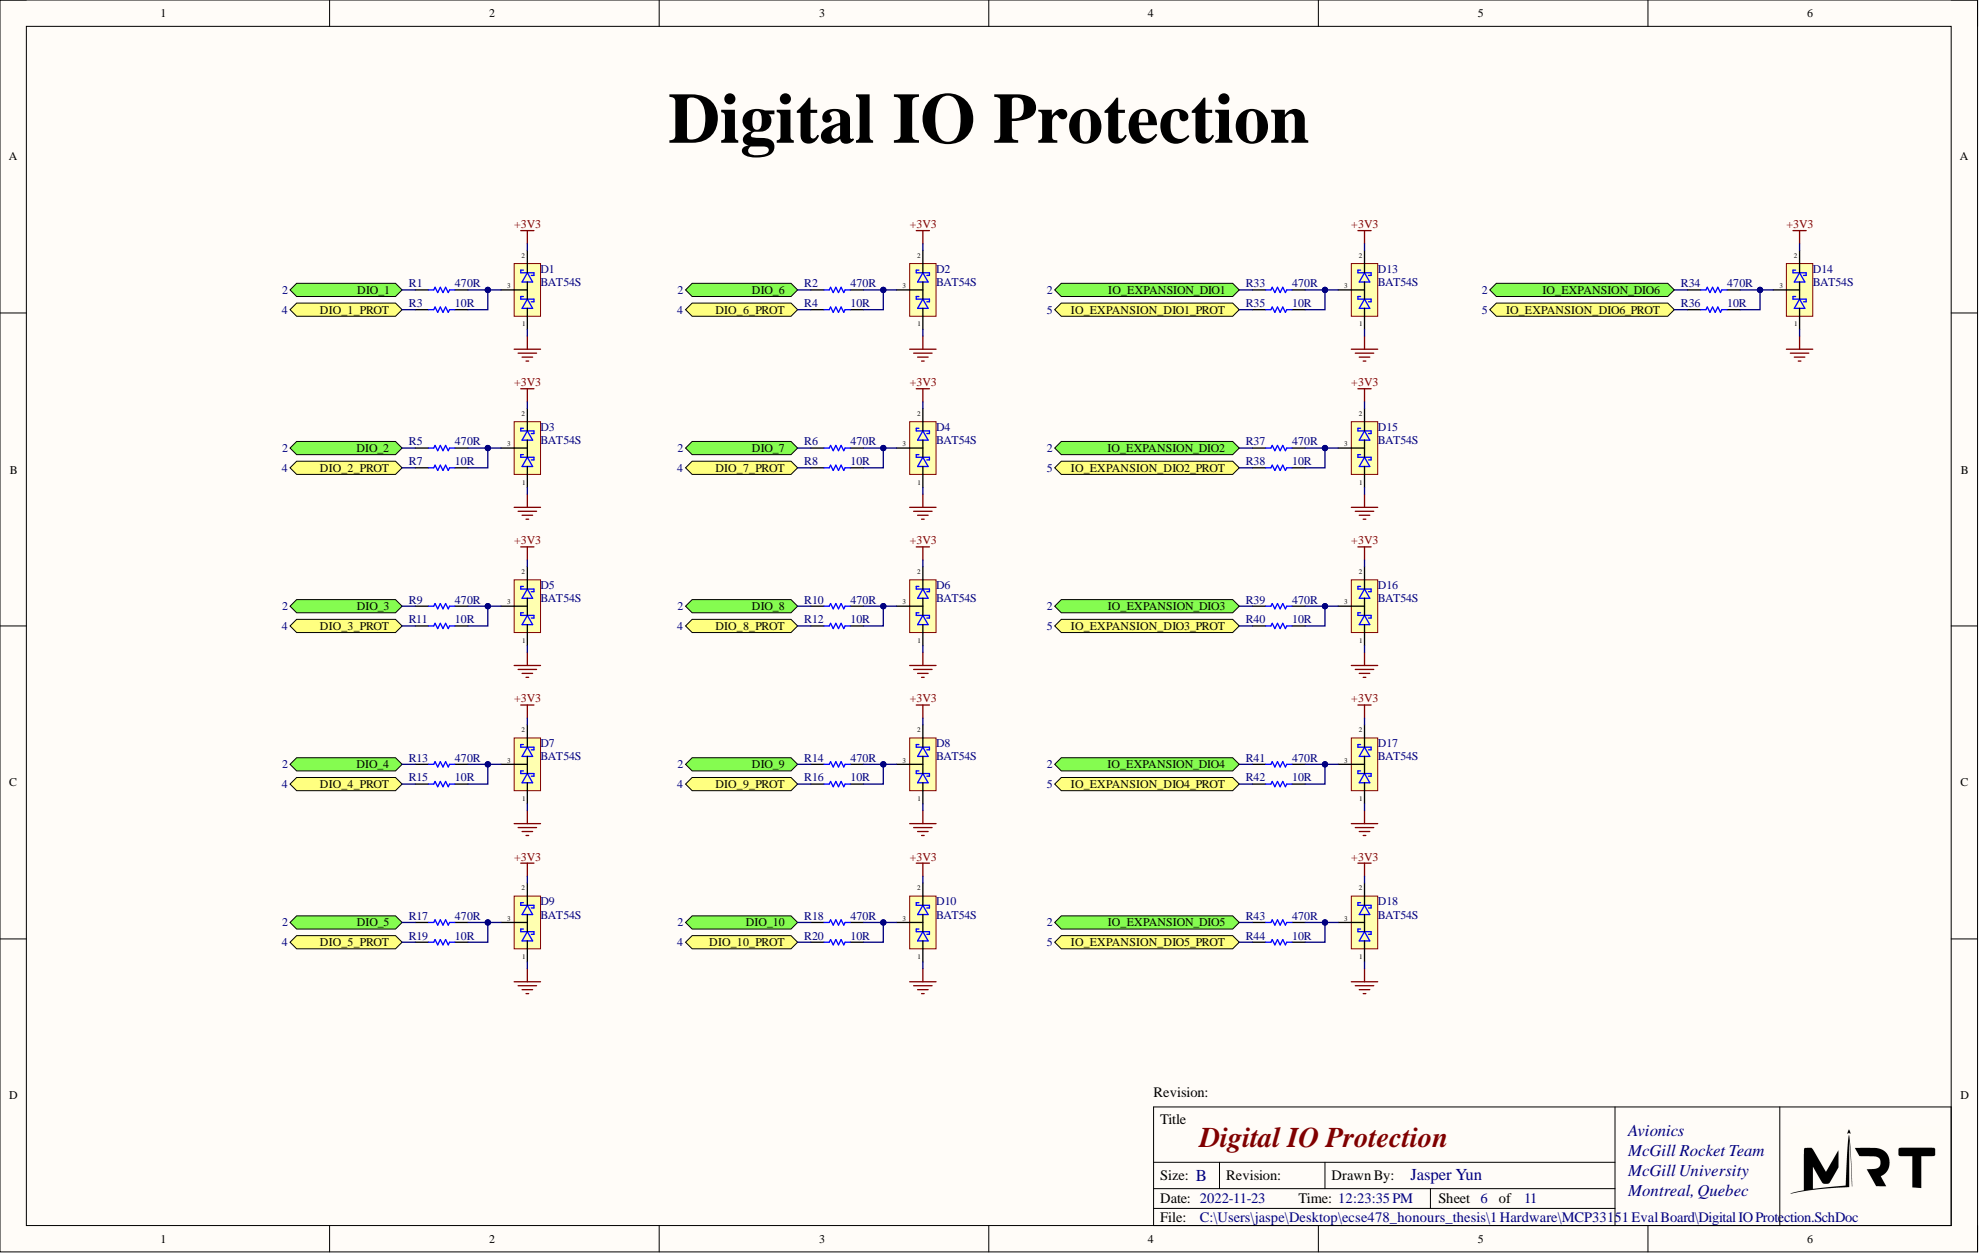
[picture p23: page 6]

File: C:\Users\jaspe\Desktop\ecse478_honours_thesis\1 Hardware\MCP33151 Eval Board\Digital IO Protection.SchDoc

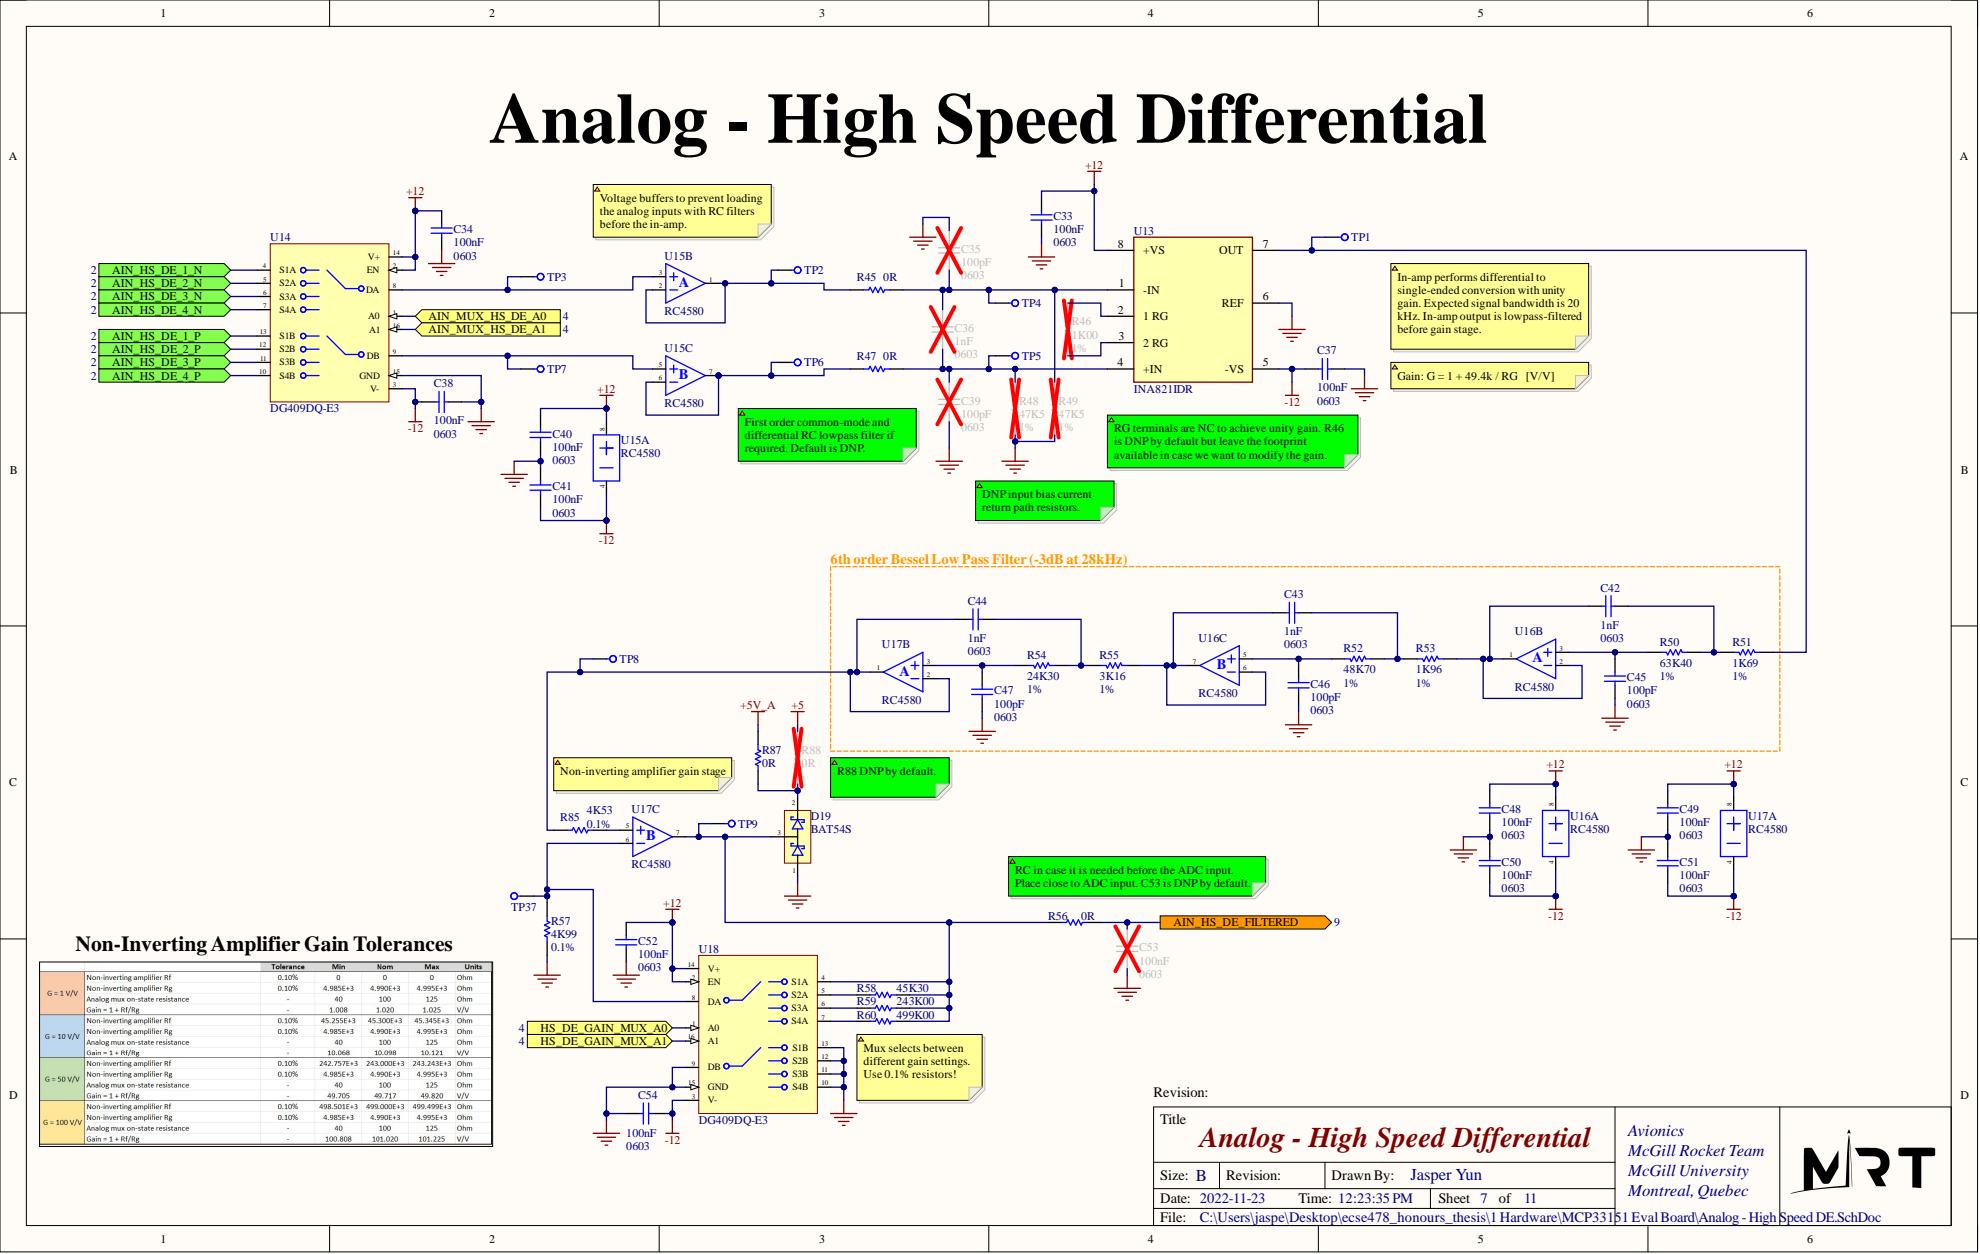
[picture p24: page 7]

Voltage buffersto prevent loading
the analog inputs with RC filters
before the in-amp.

In-amp performs differential to
single-ended conversion with unity
gain. Expected signal bandwidth is 20
kHz. In-amp output is lowpass-filtered
before gain stage.

First order common-mode and
differential RC lowpass filter if
required. Default is DNP.

RG terminals are NC to achieve unity gain. R46
is DNP by default but leave the footprint
available in case we want to modify the gain.

DNP input bias current
return path resistors.

6th orderBessel Low Pass Filter (-3dB at 28kHz)

Non-inverting amplifier gain stage

RC in case it is needed before the ADC input.
Place close to ADC input. C53 is DNP by default.

Non-Inverting Amplifier Gain Tolerances

Revision:
Analog - High Speed Differential

File: C:\Users\jaspe\Desktop\ecse478_honours_thesis\1 Hardware\MCP33151 Eval Board\Analog - High Speed DE.SchDoc

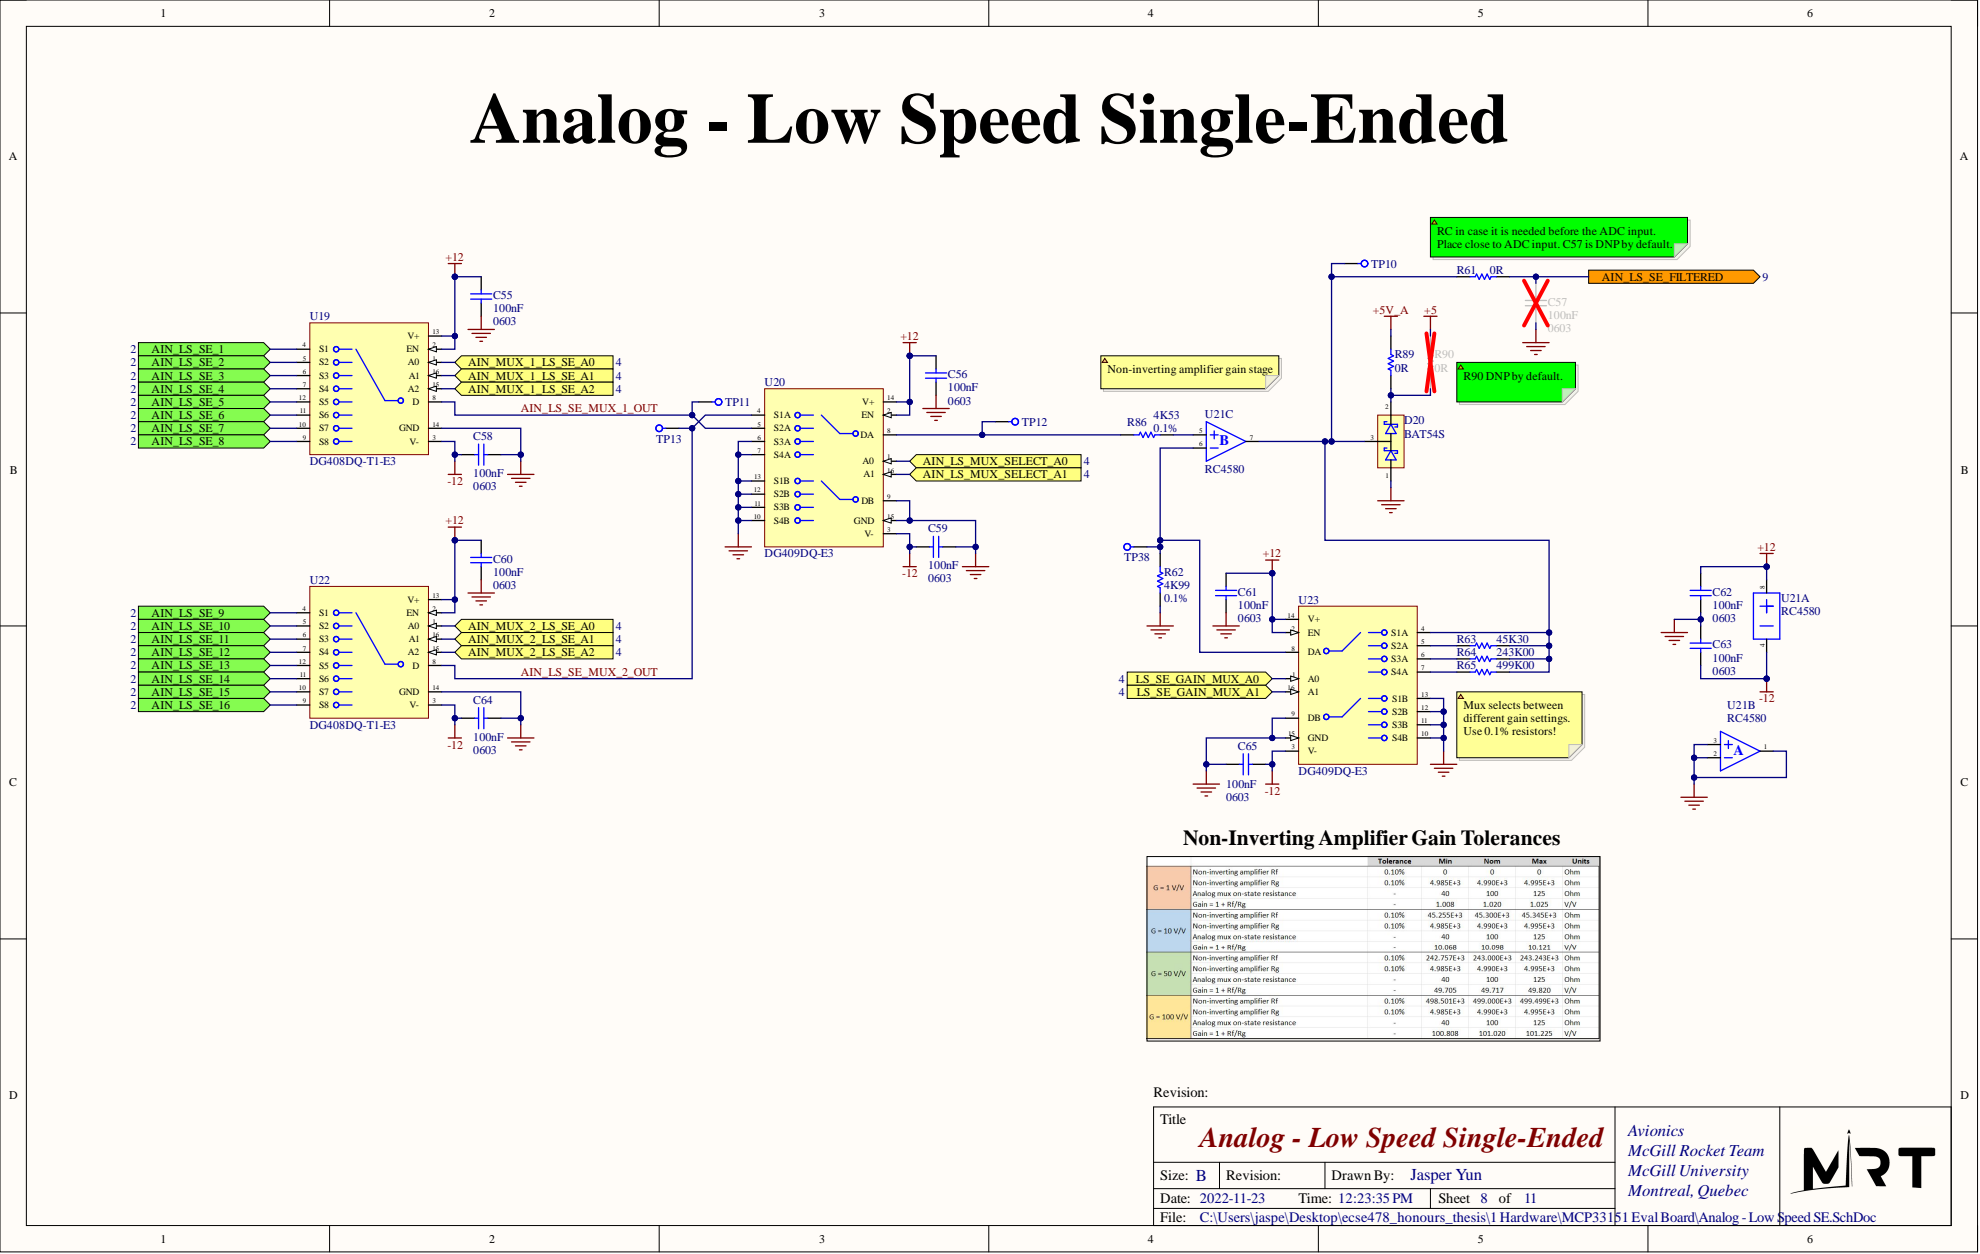
[picture p25: page 8]

Non-Inverting Amplifier Gain

Titl e | Avioni c s McG i l l Rocket Team McG i l l Universi ty Mont real , Quebec 1 Ev al Bo ard\A n a l o g -L ow | S p e e d S E . S c h D o c

Siz e : B | Re visi o n : | : Jasper Yun DrawnBy
Da te : Tim e : | S h e e t o f

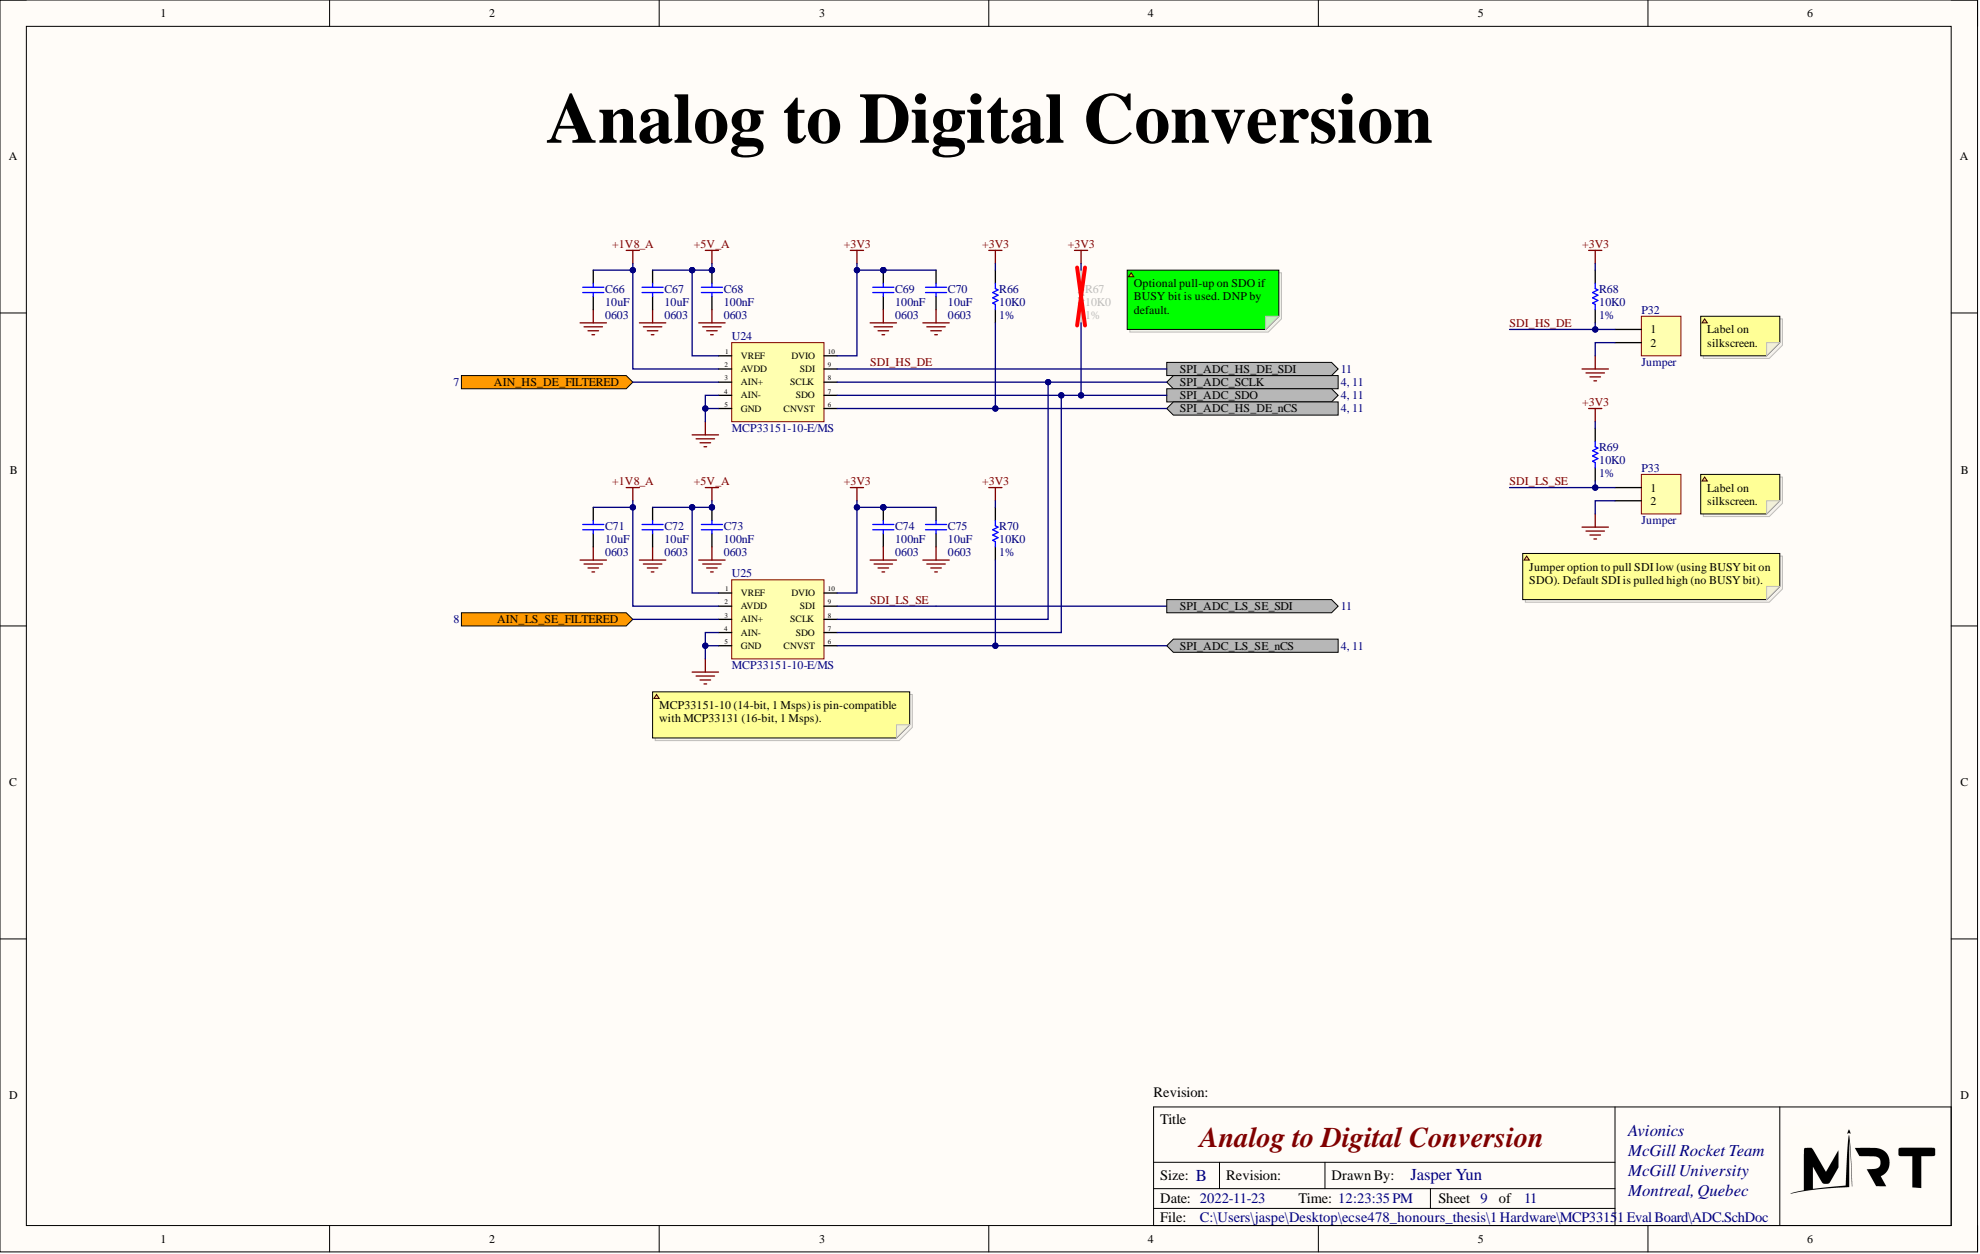
[picture p26: page 9]

Titl e | Avioni c s McG i l l Rocket Team McG i l l Universi ty Mont real , Quebec Ev al B o ard\A D C . S c h D o c

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

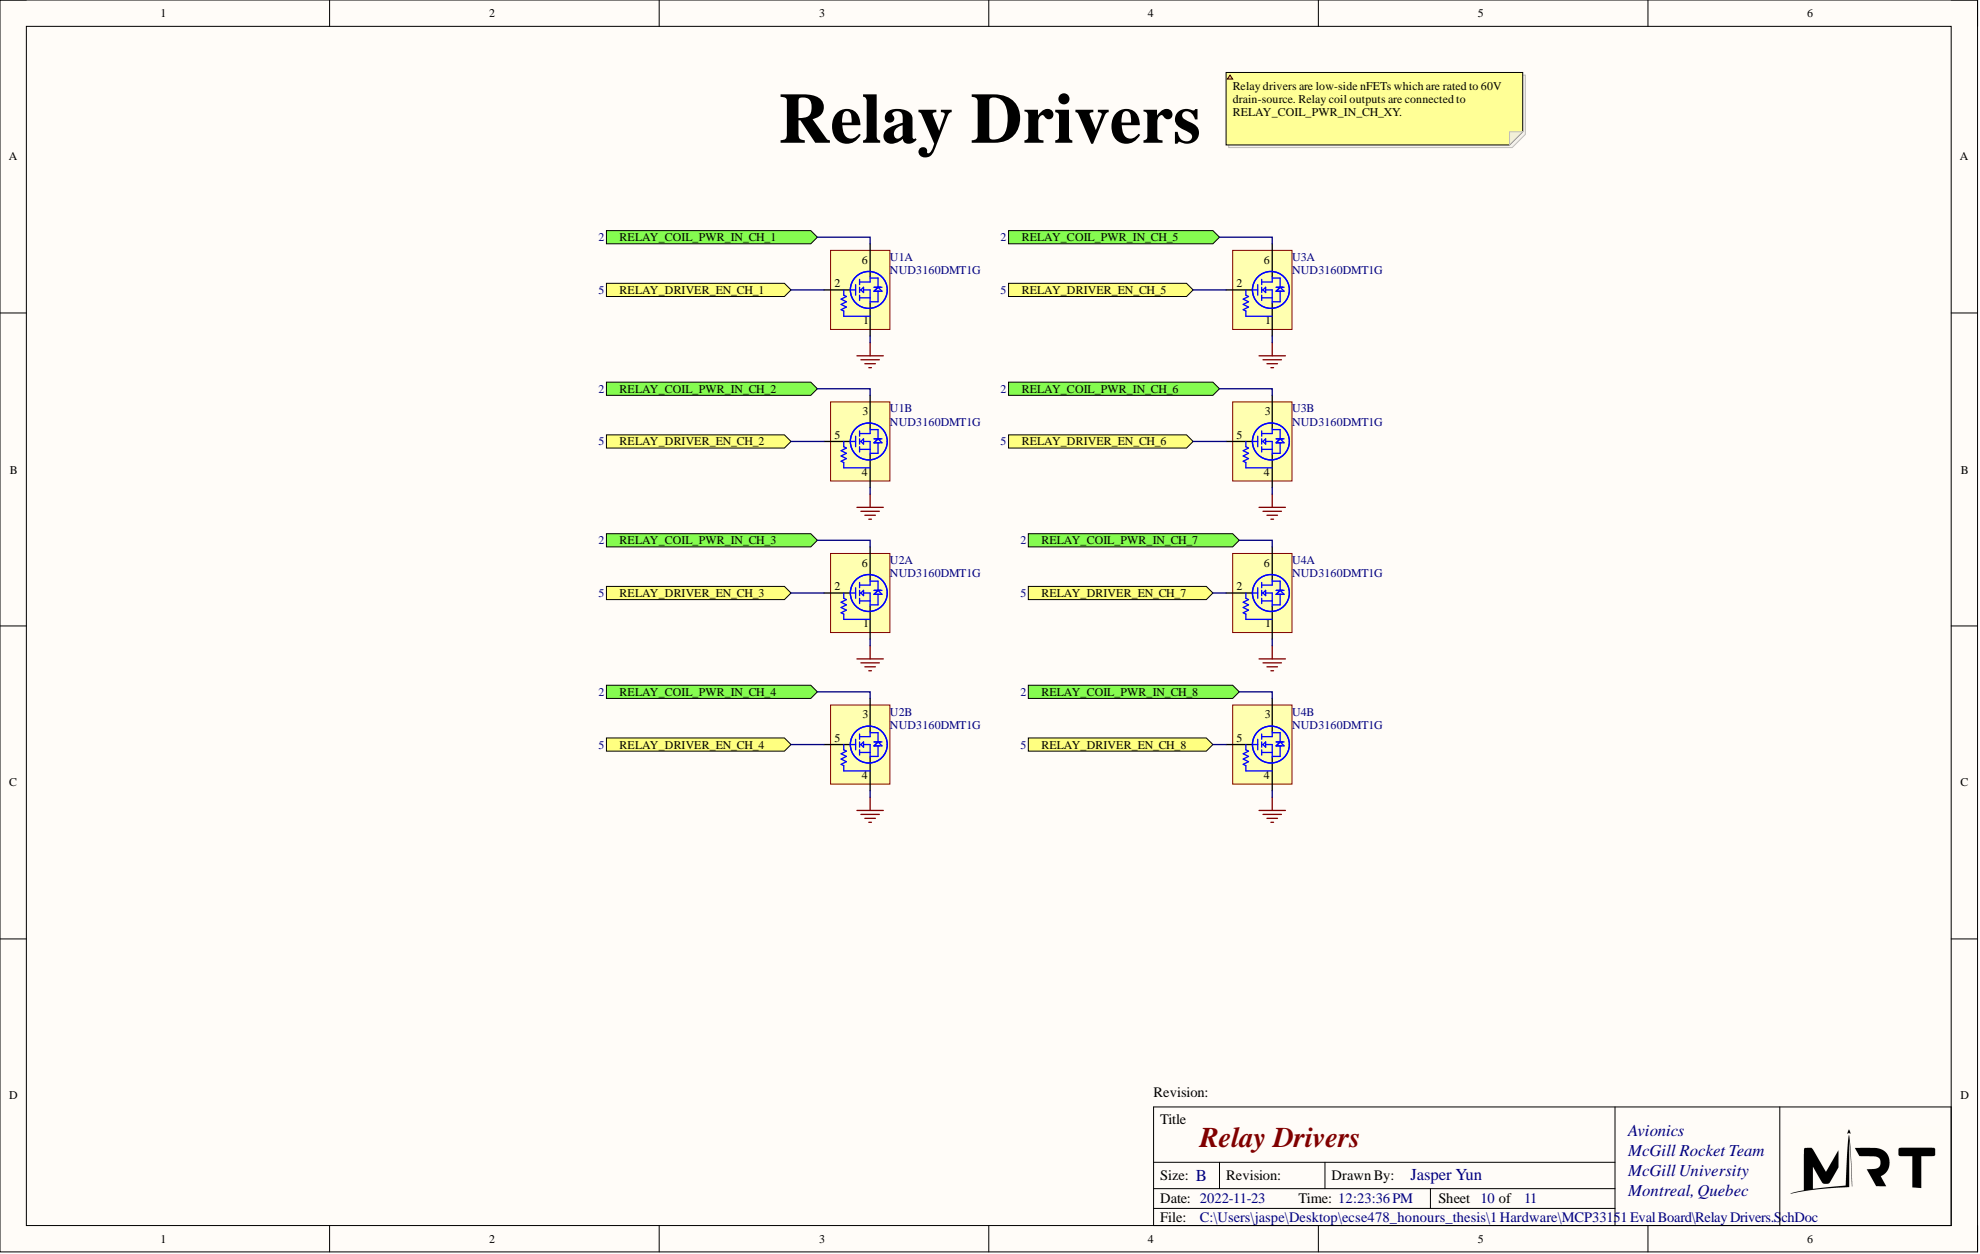
[picture p27: page 10]

Relay drivers are low-side nFETs which are rated to 60V
drain-source. Relay coil outputs are connected to
RELAY_COIL_PWR_IN_CH_XY.

File: C:\Users\jaspe\Desktop\ecse478_honours_thesis\1 Hardware\MCP33151 Eval Board\Relay Drivers.SchDoc

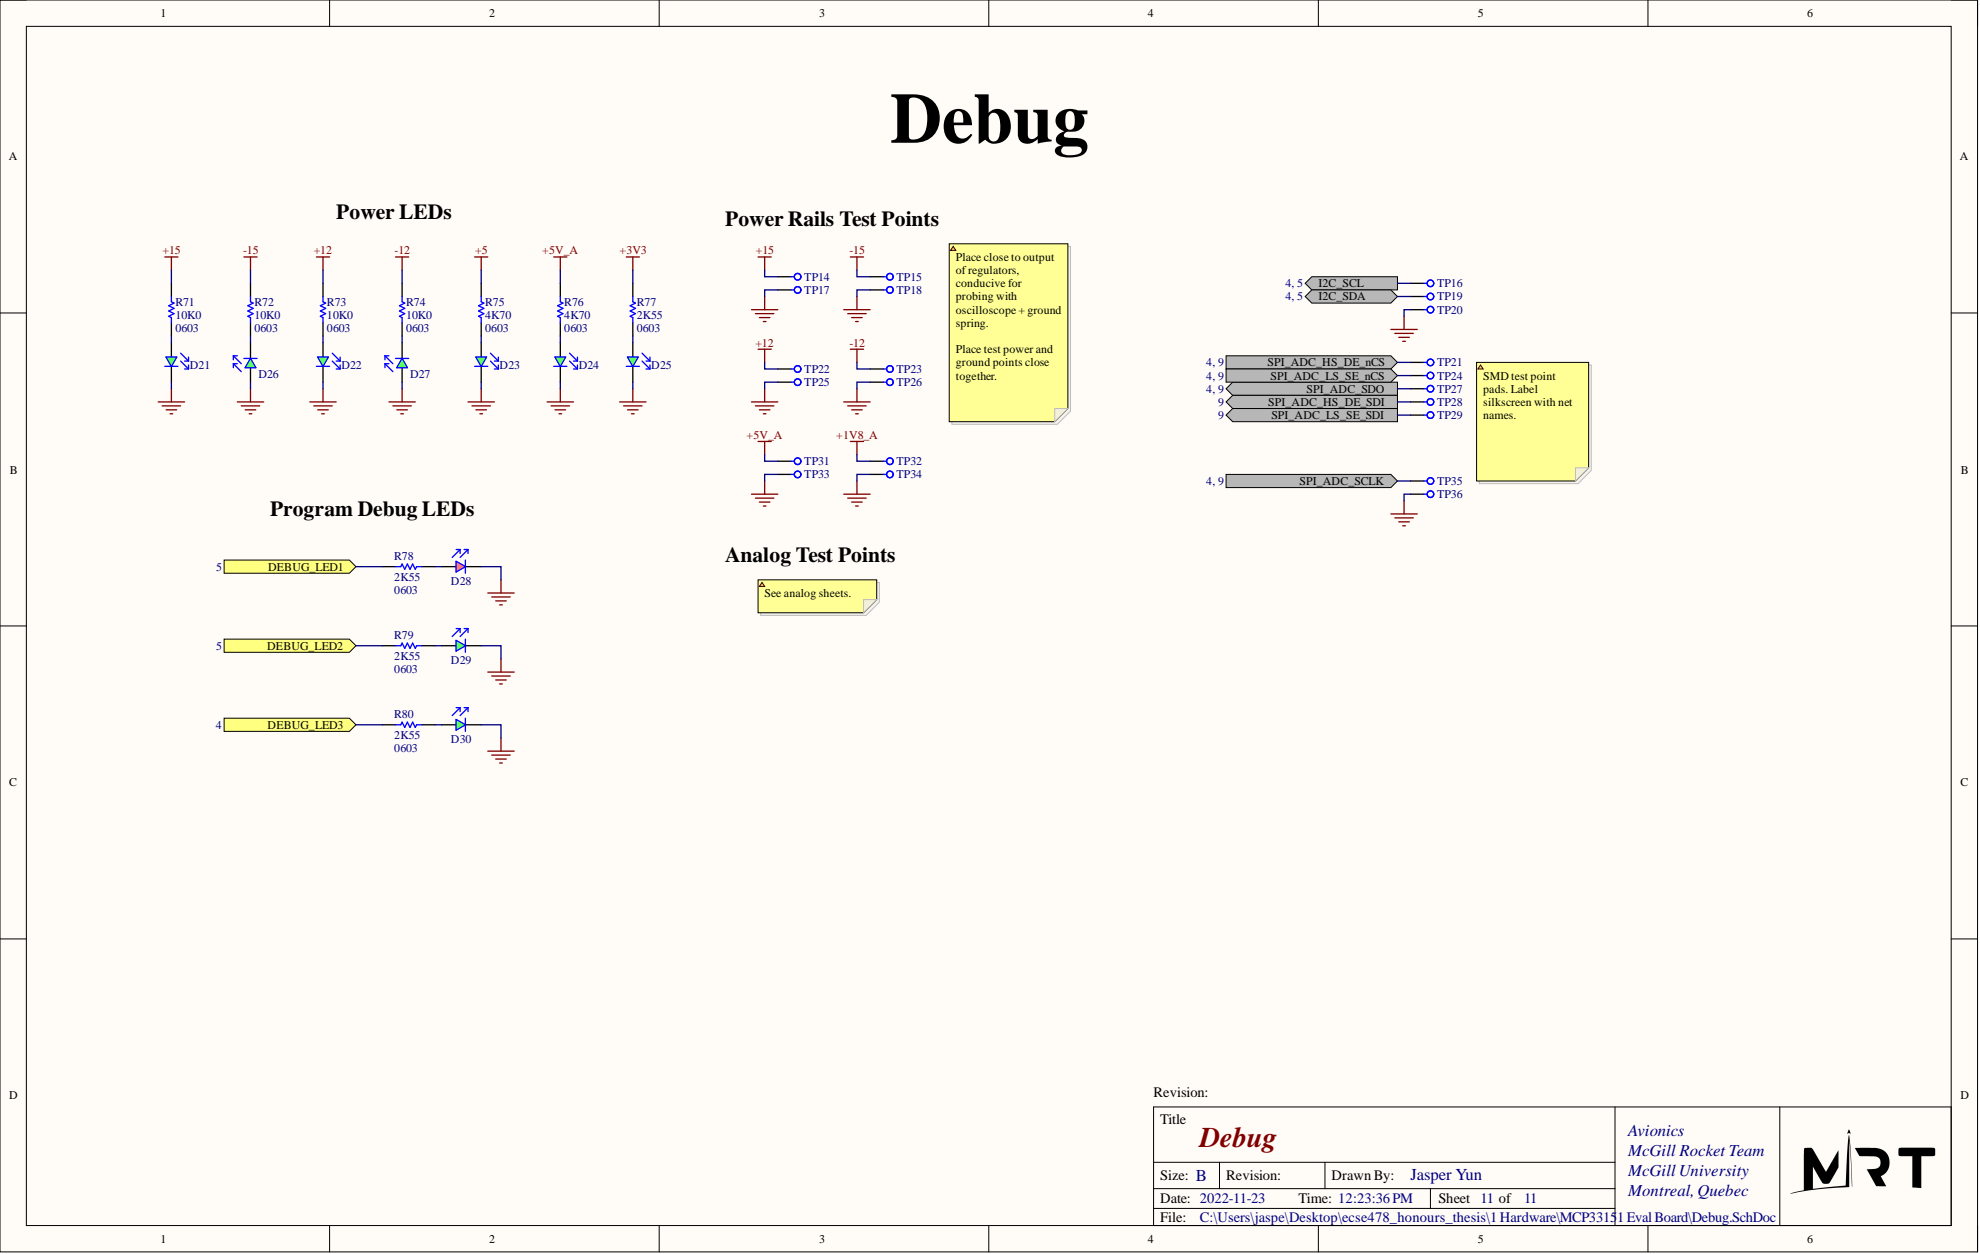
[picture p28: page 11]

Power Rails Test Points

Place close to output
of regulators,
conducive for
probing with
oscilloscope + ground
spring.

Place test power and
ground points close
together.

File: C:\Users\jaspe\Desktop\ecse478_honours_thesis\1 Hardware\MCP33151 Eval Board\Debug.SchDoc
