yunjasper/ecse478_honours_thesis/1 Hardware/ECSE478 - DAQ Device/Project Outputs for ECSE478 - DAQ Device/Draftsman - ECSE478 - DAQ Device.PDF

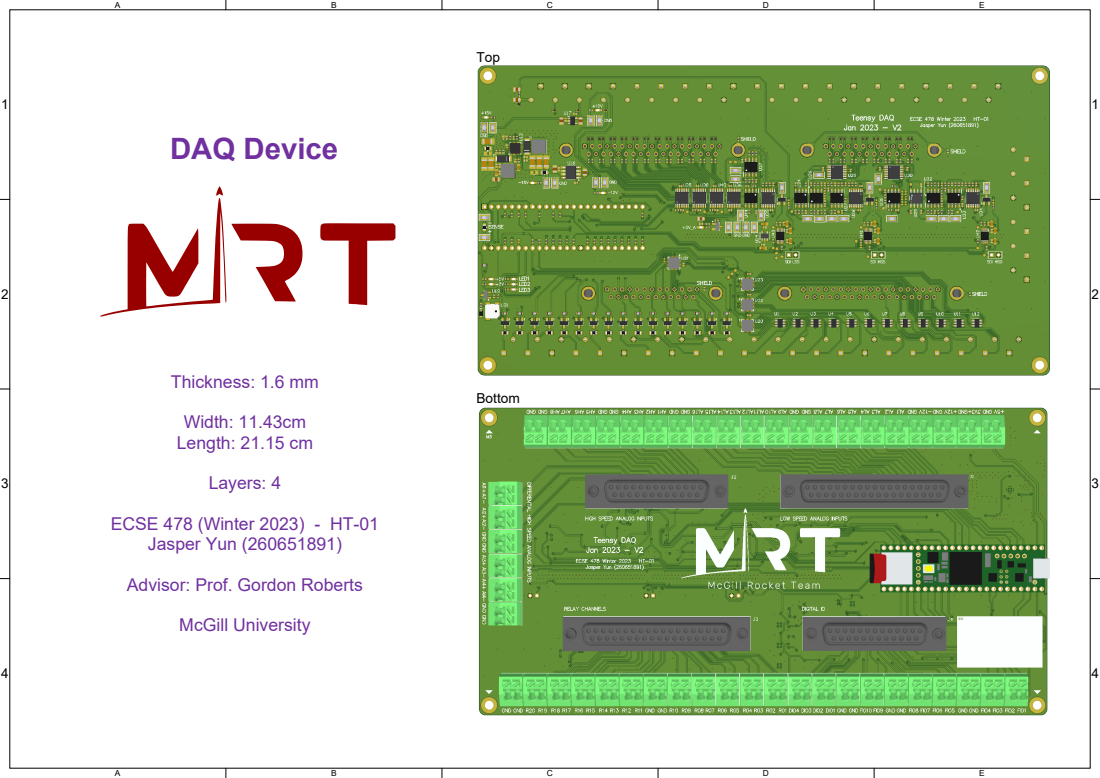
[picture p29: page 1]

Advisor: Prof. Gordon Roberts

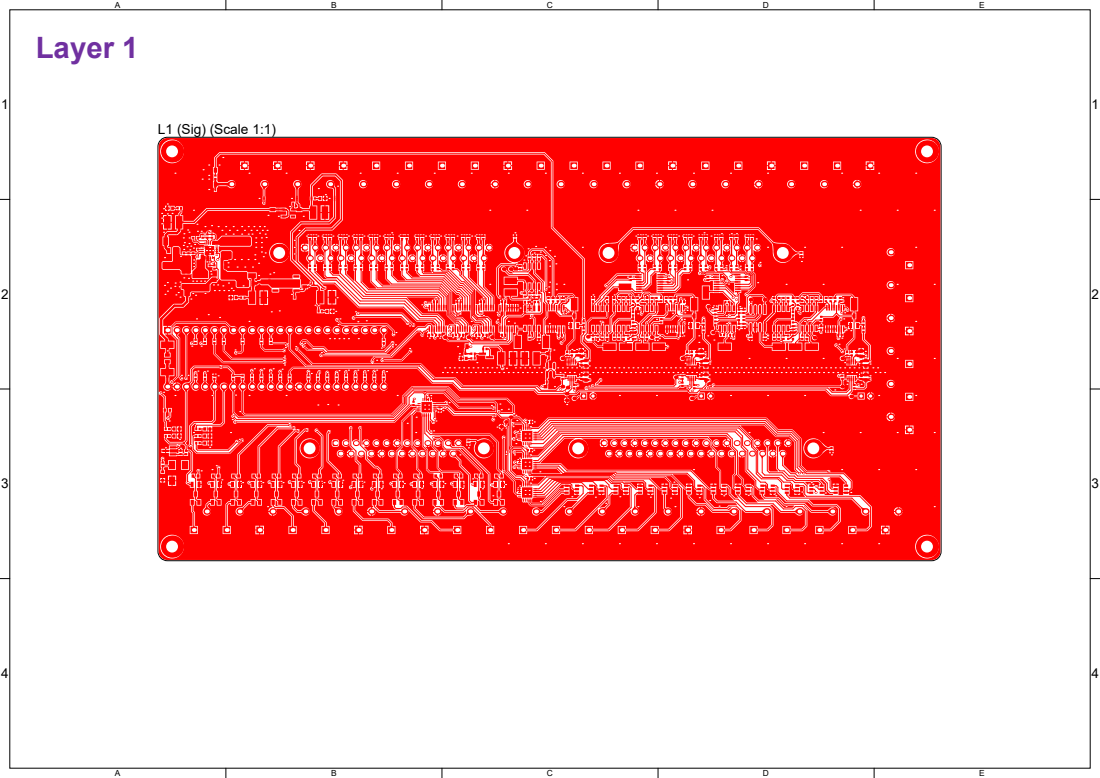
[picture p30: page 2]

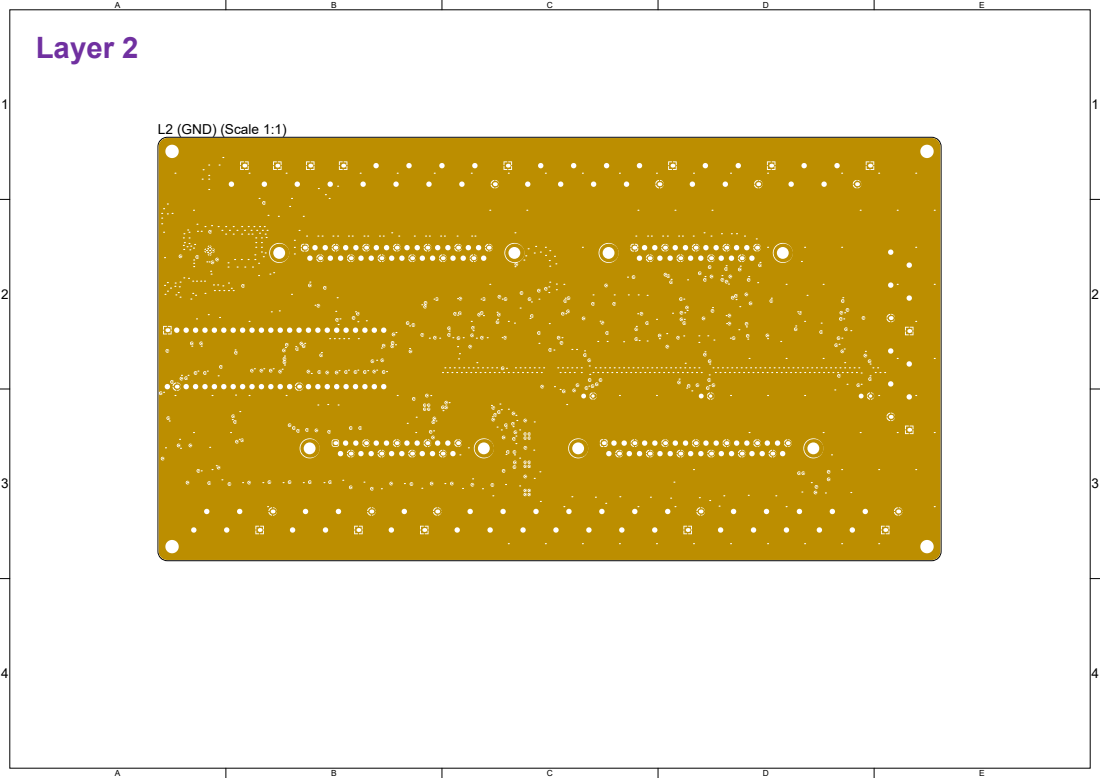
[picture p31: page 3]

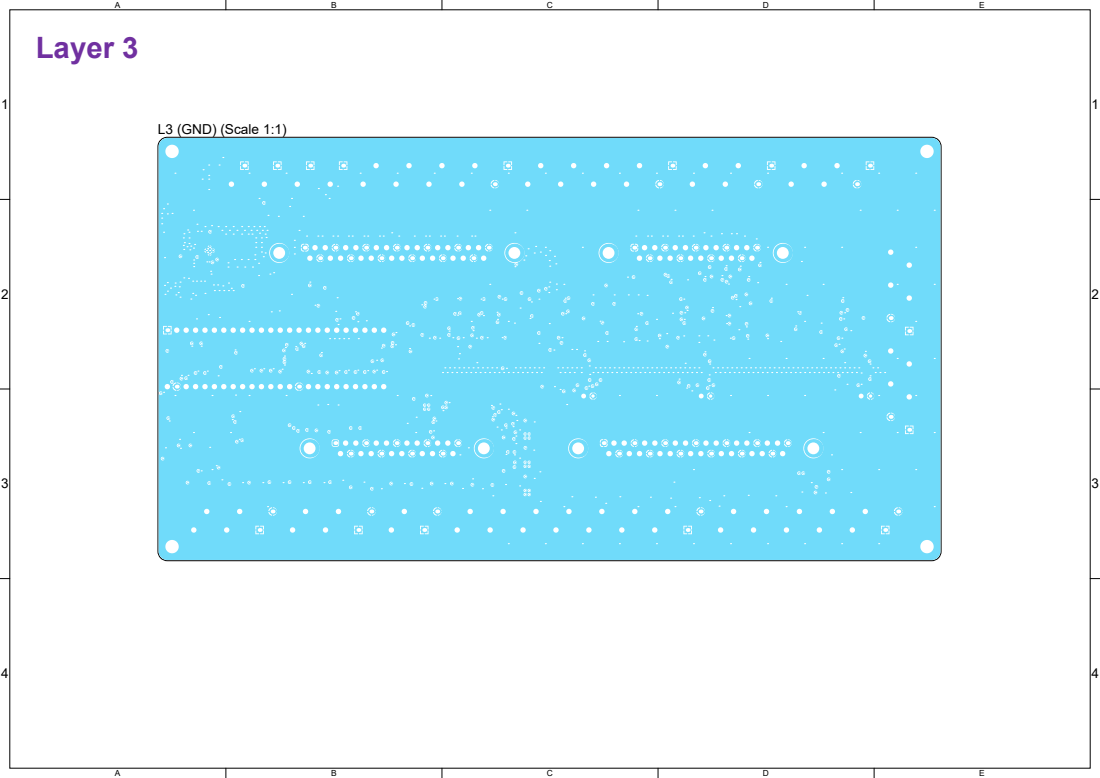
[picture p32: page 4]

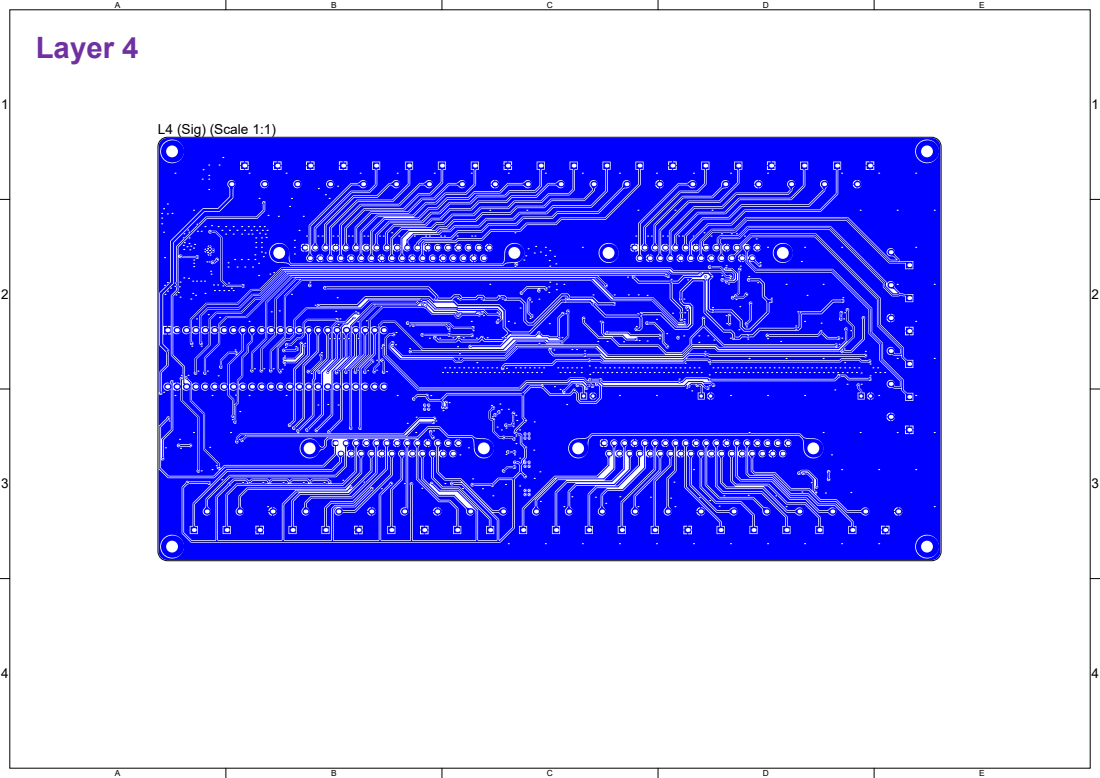
[picture p33: page 5]
