yunjasper/ecse478_honours_thesis/1 Hardware/MCP33151 Eval Board/Project Outputs for MCP33151 Eval Board/Assembly and Board Dimensions/PCB Print/Assembly and Board Dimensions.PDF

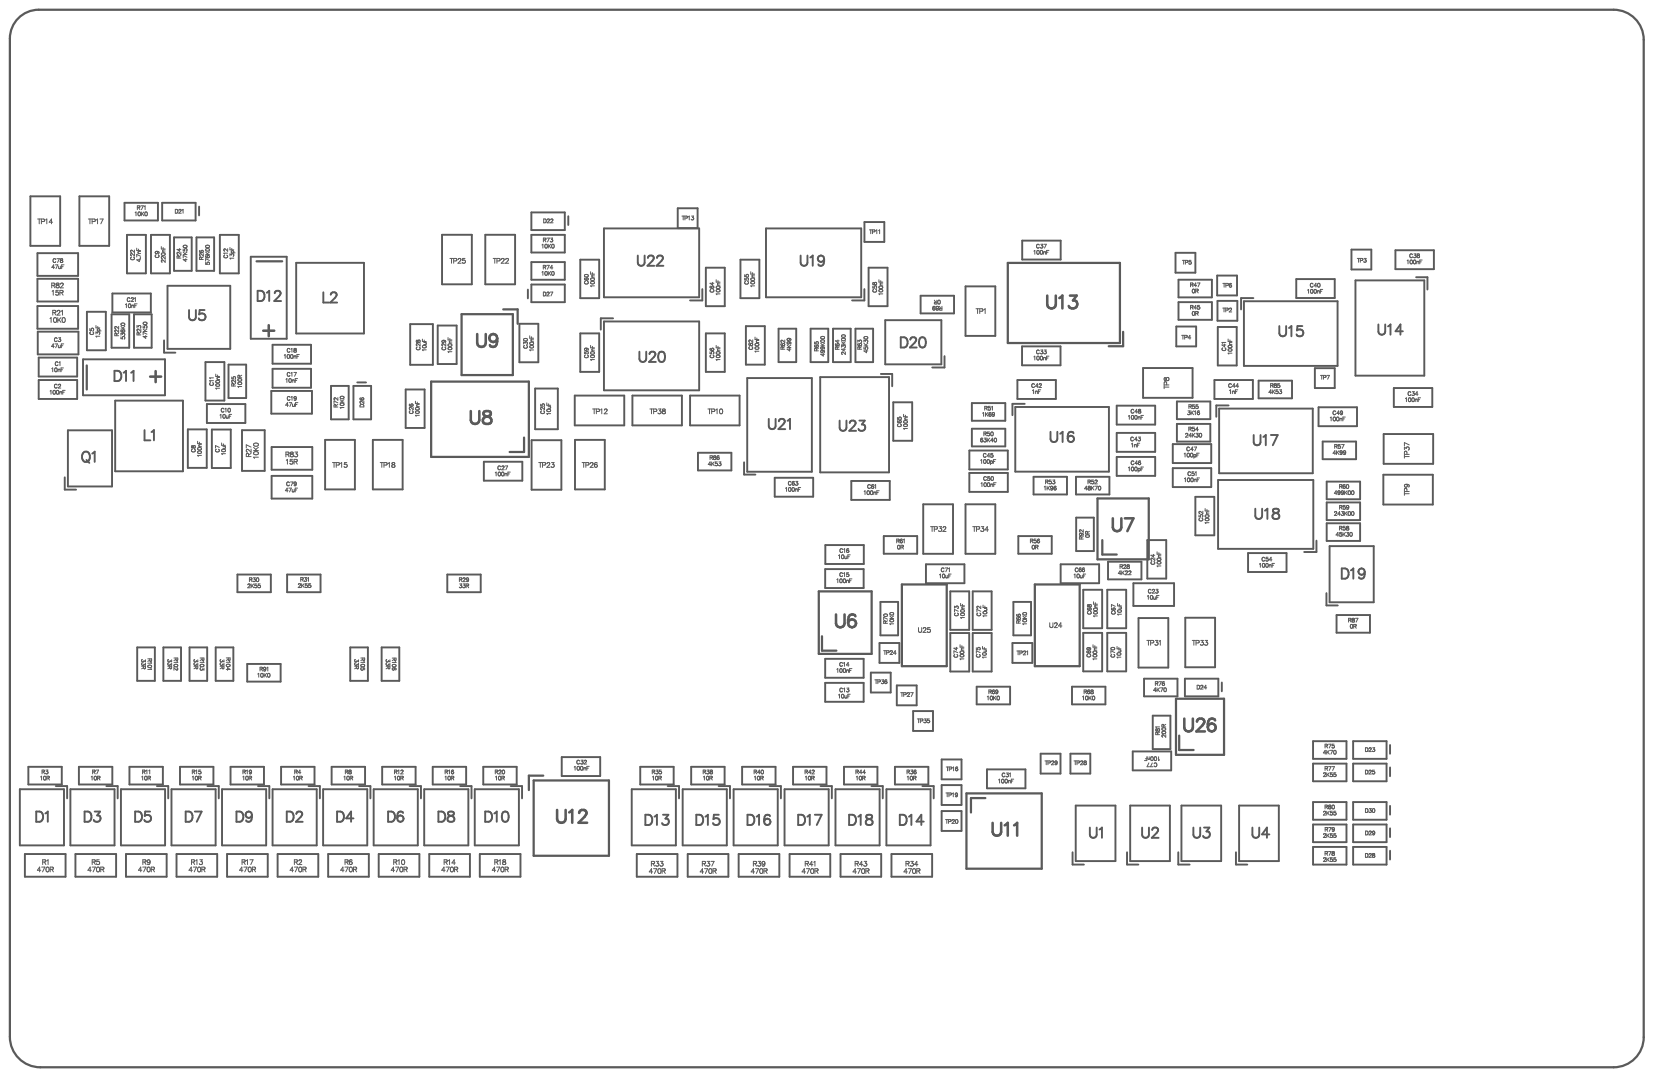
[picture p34: page 1]

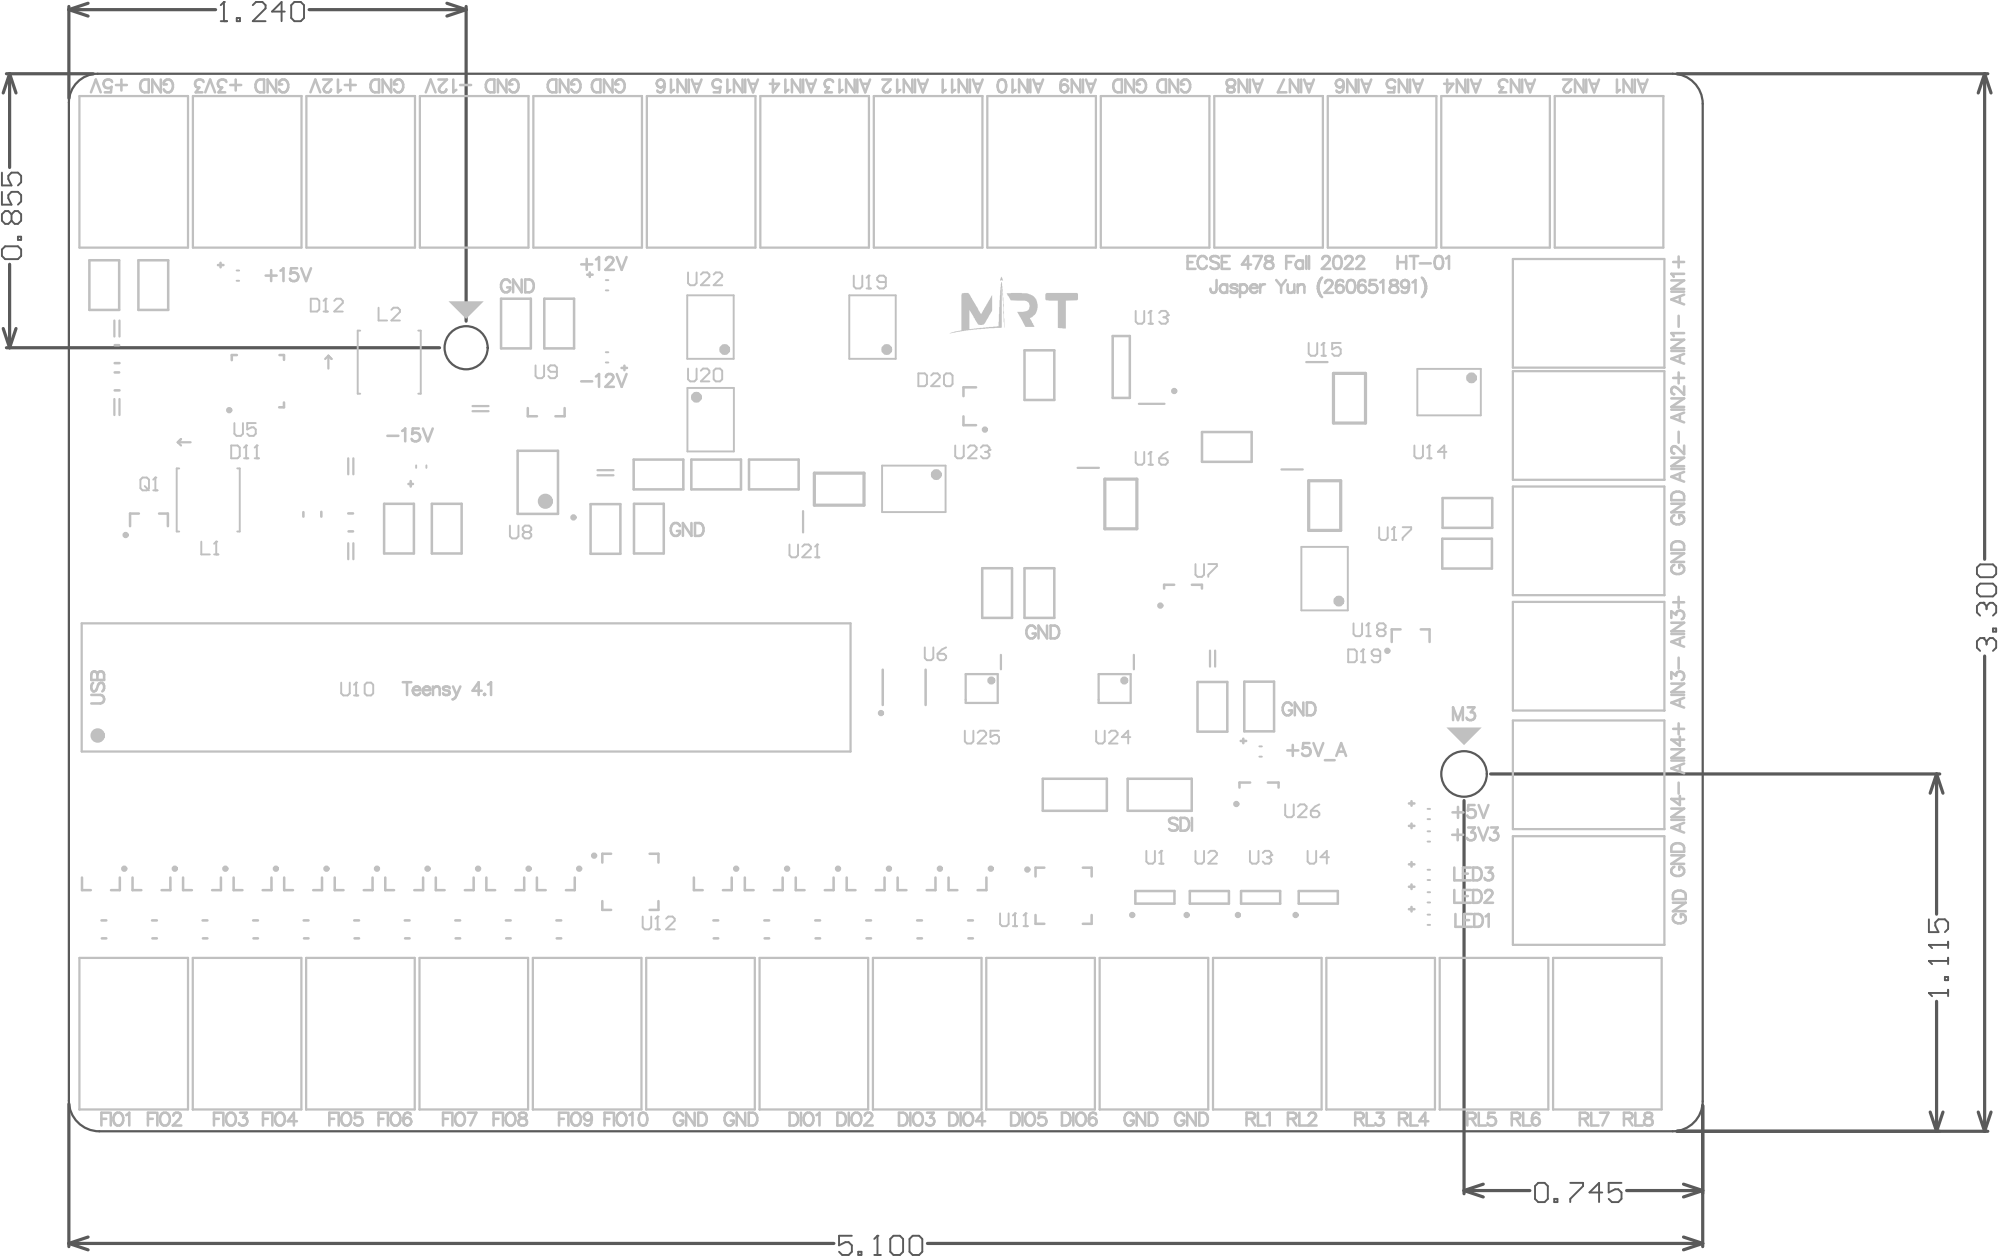
[picture p35: page 2]
