yunjasper/ecse478_honours_thesis/1 Hardware/MCP33151 Eval Board/Project Outputs for MCP33151 Eval Board/Draftsman/PCBDrawing/Draftsman.PDF

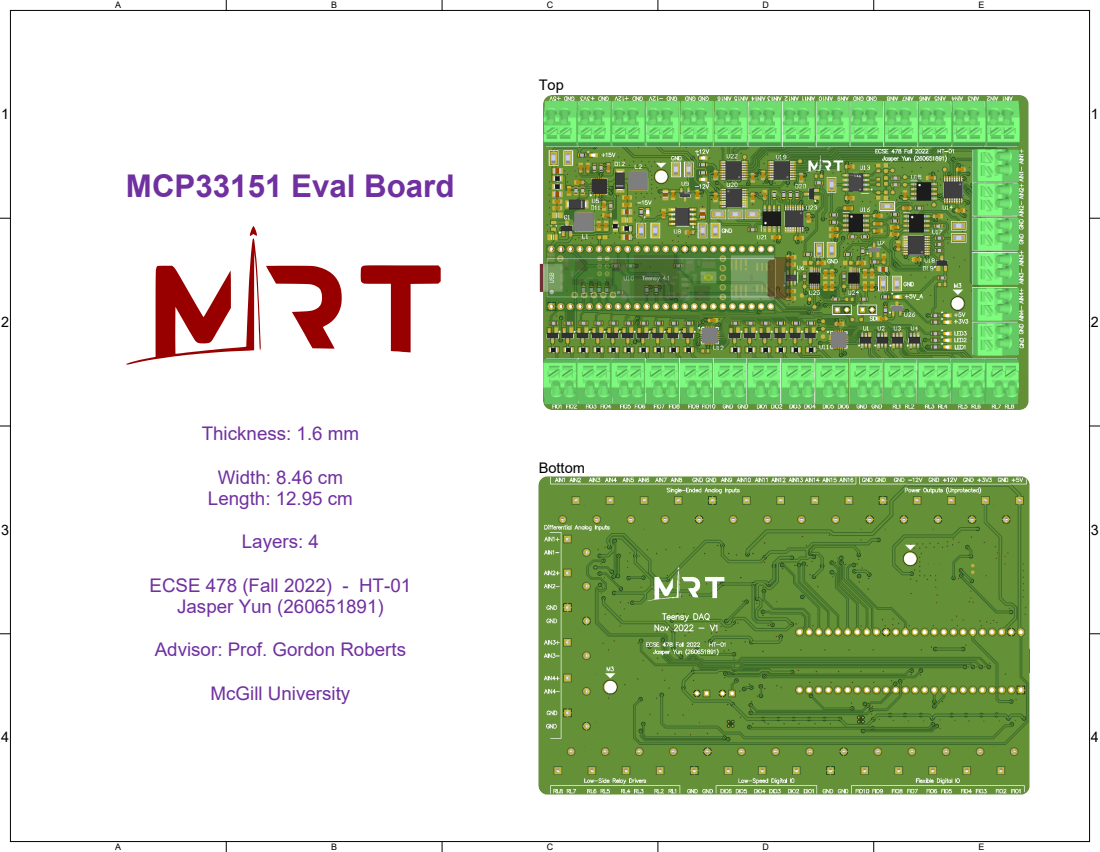
[picture p36: page 1]

Advisor: Prof. Gordon Roberts

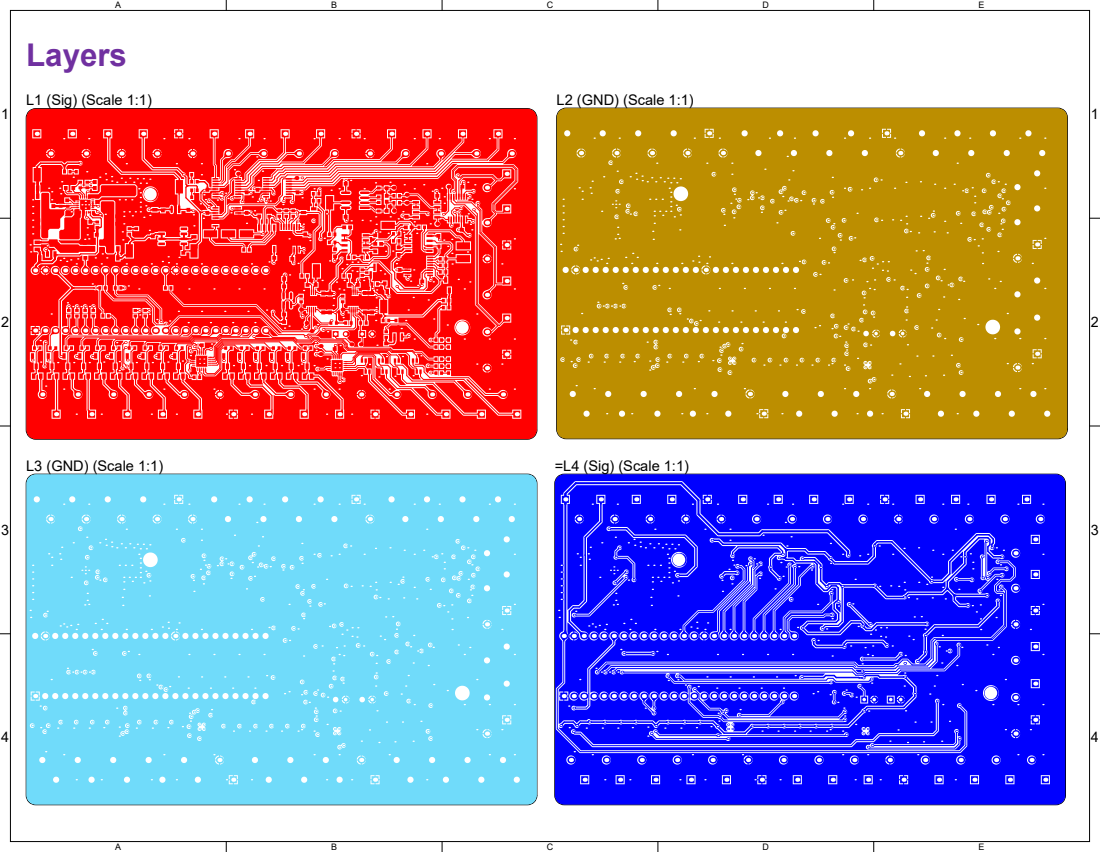
[picture p37: page 2]

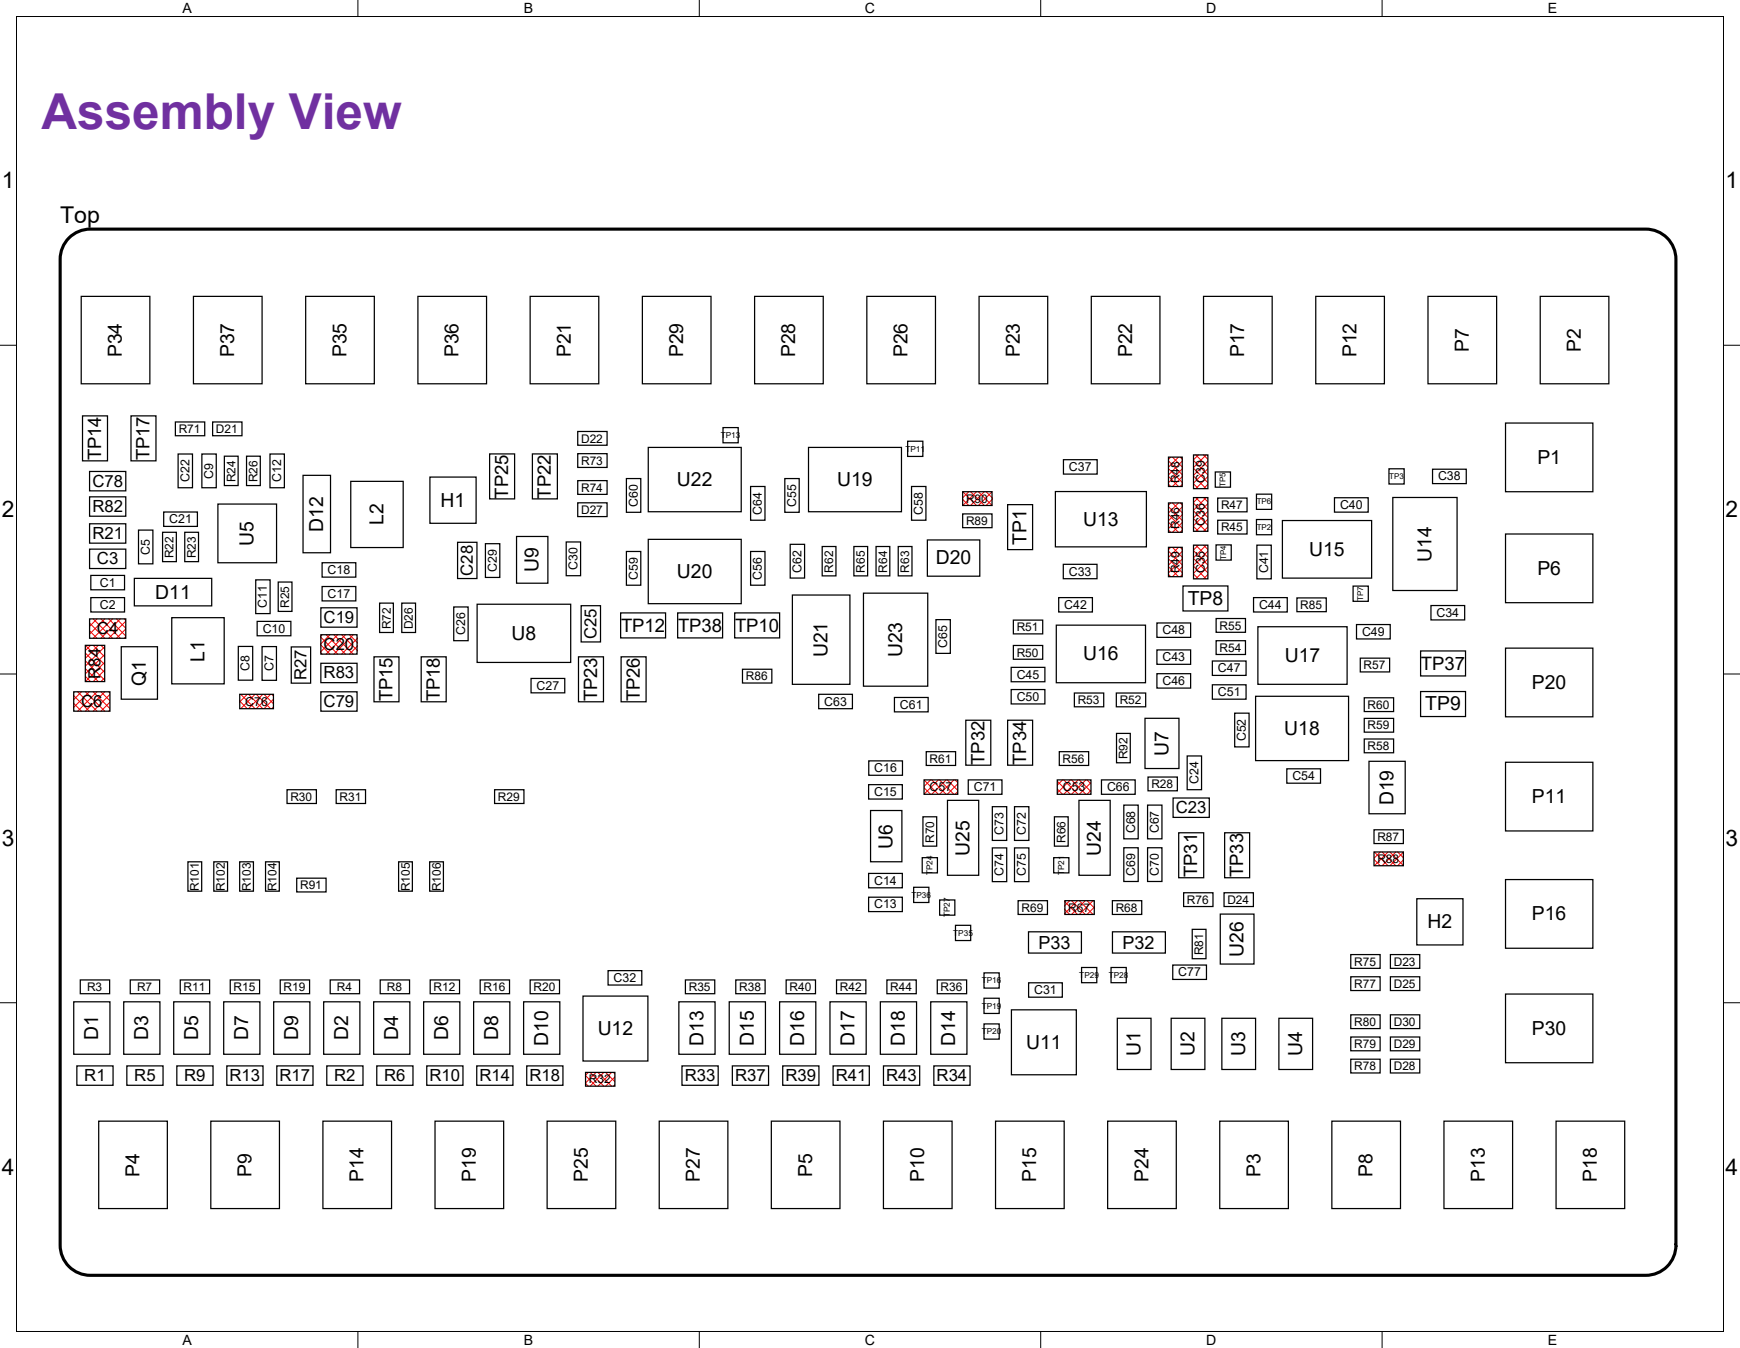
[picture p38: page 3]
