yunjasper/ecse478_honours_thesis/1 Hardware/MCP33151 Eval Board/Project Outputs for MCP33151 Eval Board/Draftsman/PCBDrawing/MCP33151 Eval Board - Draftsman.PDF

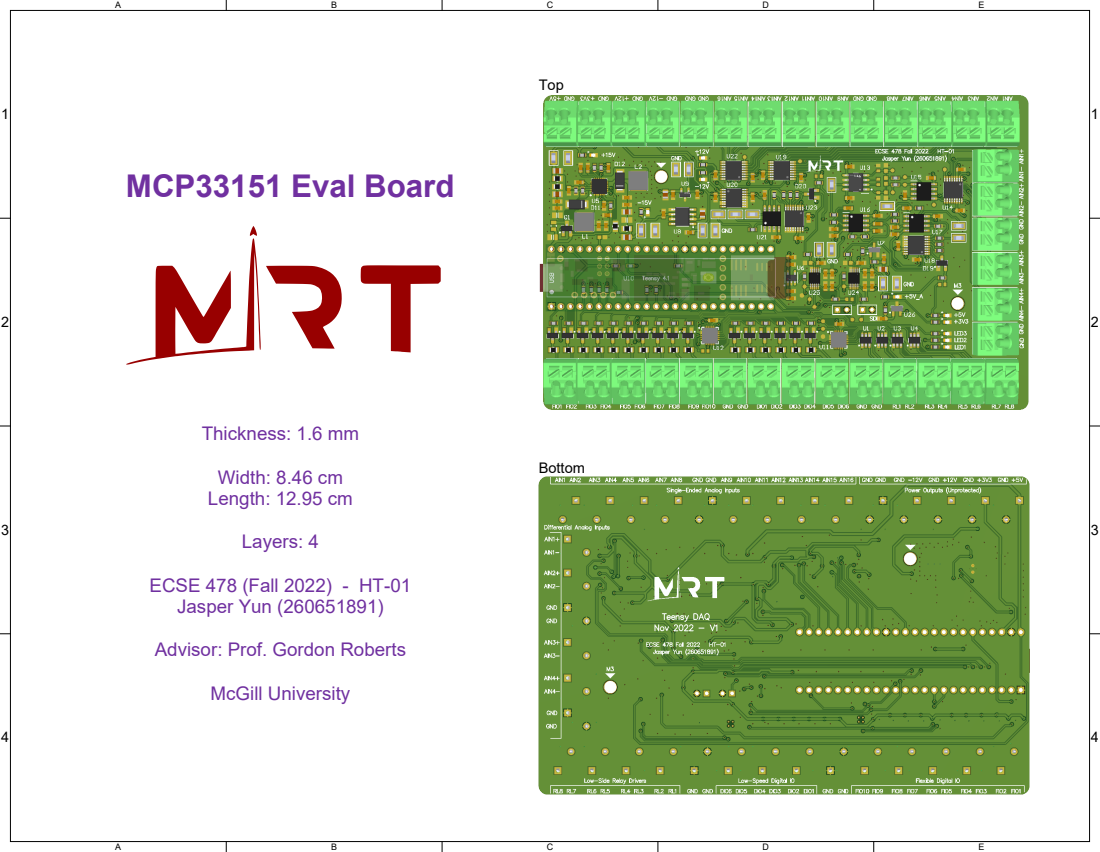
[picture p39: page 1]

Advisor: Prof. Gordon Roberts
