yunjasper/ecse478_honours_thesis/3 Simulations/Anti-Aliasing Filter 20kHz 7th order/AA filter 20kHz 7th order.asc

C1: cap; 1n
C2: cap; 100p
C3: cap; 1n
C4: cap; 100p
C5: cap; 1n
C6: cap; 51p
C7: cap; 1n
R1: res; 6.36k
R2: res; 5.49k
R3: res; 73.2k
R4: res; 3.65k
R5: res; 110k
R6: res; 28.7k
R7: res; 28.7k
Rs: res; 1k
U1: AD711
U2: AD711
U3: AD711
U4: AD711
U5: AD711
V1: voltage; {Vs}
V2: voltage; {Vs}
V3: voltage; SINE(2.5 0.001 2k); AC 1
Vsig1: voltage; SINE(-5 2 15k)
Vsig2: voltage; SINE(-1 3 1k)
Vsig3: voltage; SINE(1 0.5 50k)
Vsig: voltage; SINE(0 1 10)
Named nets: 0, vee, vcc, vout, vin
.param Vs=12
.ac dec 100 1 100Meg
.tran 0.001
