yunjasper/ecse478_honours_thesis/3 Simulations/Anti-Aliasing Filter 30kHz 6th order Bessel/Anti-Aliasing Filter 30kHz 6th order Bessel - AD8030.asc

C1: cap; 100p
C2: cap; 1n
C3: cap; 100p
C4: cap; 1n
C5: cap; 100p
C6: cap; 1n
R1: res; 1.69k
R2: res; 63.4k
R3: res; 1.96k
R4: res; 48.7k
R5: res; 3.16k
R6: res; 24.3k
R7: res; 4.99k
R8: res; 4.99k
R9: res; 2.5k
R10: res; {Rf1}
R11: res; {Rf2}
R12: res; {Rf3}
R13: res; 1k
R14: res; 1k
U1: AD8030
U2: AD8030
U3: AD8030
U4: AD711
U5: AD8030
V1: voltage; 0; AC 1
V2: voltage; 12
V3: voltage; 12
V4: voltage; PWL file=thrust_points.csv
Vsig1: voltage; SINE(0 1 10)
Vsig2: voltage; SINE(-5 2 15k)
Vsig3: voltage; SINE(-1 3 1k)
Vsig4: voltage; SINE(1 2 50k)
Named nets: 0, vcc, vee, vfilt, vamp
.ac oct 100 1 1Meg
.tran 15m
.param Rf1=if(Rf<1,1u,65.09k)
.param Rf2=if(Rf<1,1u,50.66k)
.param Rf3=if(Rf<1,1u,27.46k)
.param Rf=0
if Rf = 0, then feedback resistors are all jumpers (0R)
