yunjasper/ecse478_honours_thesis/3 Simulations/Anti-Aliasing Filter 30kHz 6th order Bessel/Anti-Aliasing Filter 30kHz 6th order Bessel.asc

C1: cap; 100p
C2: cap; 1n
C3: cap; 100p
C4: cap; 1n
C5: cap; 100p
C6: cap; 1n
D1: schottky; BAT54
D2: schottky; BAT54
R1: res; 1.69k
R2: res; 63.4k
R3: res; 1.96k
R4: res; 48.7k
R5: res; 3.16k
R6: res; 24.3k
R7: res; 4.99k
R8: res; 1m
R9: res; 2.5k
R10: res; {Rf1}
R11: res; {Rf2}
R12: res; {Rf3}
R13: res; 10k
R15: res; 10k
U1: AD711
U2: AD711
U3: AD711
U4: AD711
U5: AD711
U6: AD711
V1: voltage; 3; AC 1
V2: voltage; 12
V3: voltage; 12
V4: voltage; PWL file=thrust_points.csv
V5: voltage; 5
Vsig1: voltage; SINE(0 1 10)
Vsig2: voltage; SINE(-5 2 15k)
Vsig3: voltage; SINE(-1 3 1k)
Vsig4: voltage; SINE(1 2 50k)
Named nets: 0, vcc, vee, vfilt, vamp, vs, vdiv
.ac oct 100 1 1Meg
.dc V1 0 15 0.5
.param Rf=1
if Rf = 0, then feedback resistors are all jumpers (0R)
.param Rf1=if(Rf<1,1u,65.09k)
.param Rf2=if(Rf<1,1u,50.66k)
.param Rf3=if(Rf<1,1u,27.46k)
