yunjasper/ecse478_honours_thesis/3 Simulations/Anti-Aliasing Filter 30kHz 6th order Bessel/Anti-Aliasing Filter 30kHz 6th order Bessel_for_poster.asc

C1: cap; 100p
C2: cap; 1n
C3: cap; 100p
C4: cap; 1n
C5: cap; 100p
C6: cap; 1n
D1: schottky; BAT54
D2: schottky; BAT54
R1: res; 1.69k
R2: res; 63.4k
R3: res; 1.96k
R4: res; 48.7k
R5: res; 3.16k
R6: res; 24.3k
R7: res; 4.99k
R8: res; 1m
R9: res; 2.5k
R10: res; 65.09k
R11: res; 50.66k
R12: res; 27.46k
R13: res; 1k
U1: AD711
U2: AD711
U3: AD711
U4: AD711
V1: voltage; 3; AC 1
V2: voltage; 12
V3: voltage; 12
V4: voltage; PWL file=thrust_points.csv
V5: voltage; 5
Named nets: 0, vcc, vee, vfilt, vamp, vs
.ac oct 100 1 1Meg
.dc V1 0 15 0.5
