yunjasper/ecse478_honours_thesis/3 Simulations/DAQ Device Op Amp Clamp Protection Mistake/DAQ Device Op Amp Clamp Protection Mistake.asc

D1: schottky; BAT54
D2: schottky; BAT54
R1: res; 1Meg
R2: res; 1µ
R3: res; 45k
R4: res; 4.99k
U1: AD711
V1: voltage; 10
V2: voltage; 10
V3: voltage; SINE(0.25 0.5 1k)
V4: voltage; 5
Named nets: 0, vcc, vee, adc, o
.tran 5m
