yunjasper/ecse478_honours_thesis/3 Simulations/Digital Input Protection/Digital Input Protection.asc

D1: schottky; 1N5819
D2: schottky; 1N5819
R1: res; 10
R2: res; 220
R3: res; 1Meg
V1: voltage; PULSE(0 3.3 0 1n 1n 1u 2u)
V2: voltage; PWL(0 35 5 -35 5.01 0 6 3.3 10 0)
V3: voltage; 3.3
Named nets: 0, Vpin, Vin
.tran 10u
Microcontroller
