yunjasper/ecse478_honours_thesis/(list of files, drawings)

Other design files:
1 Hardware/ECSE478 - DAQ Device/ADC.SchDoc
1 Hardware/ECSE478 - DAQ Device/Analog - High Speed DE.SchDoc
1 Hardware/ECSE478 - DAQ Device/Analog - High Speed SE.SchDoc
1 Hardware/ECSE478 - DAQ Device/Analog - Low Speed SE.SchDoc
1 Hardware/ECSE478 - DAQ Device/Breadboard Prototyping Schematic.SchDoc
1 Hardware/ECSE478 - DAQ Device/Connectors - Analog.SchDoc
1 Hardware/ECSE478 - DAQ Device/Connectors - Digital.SchDoc
1 Hardware/ECSE478 - DAQ Device/Cover.SchDoc
1 Hardware/ECSE478 - DAQ Device/Debug.SchDoc
1 Hardware/ECSE478 - DAQ Device/Digital IO Protection.SchDoc
1 Hardware/ECSE478 - DAQ Device/ECSE478 - DAQ Device.PrjPcb
1 Hardware/ECSE478 - DAQ Device/IO Expansion.SchDoc
1 Hardware/ECSE478 - DAQ Device/Microcontroller.SchDoc
1 Hardware/ECSE478 - DAQ Device/Power.SchDoc
1 Hardware/ECSE478 - DAQ Device/Relay Drivers.SchDoc
1 Hardware/MCP33151 Eval Board/ADC.SchDoc
1 Hardware/MCP33151 Eval Board/Analog - High Speed DE.SchDoc
1 Hardware/MCP33151 Eval Board/Analog - Low Speed SE.SchDoc
1 Hardware/MCP33151 Eval Board/Connectors.SchDoc
1 Hardware/MCP33151 Eval Board/Cover.SchDoc
1 Hardware/MCP33151 Eval Board/Debug.SchDoc
1 Hardware/MCP33151 Eval Board/Digital IO Protection.SchDoc
1 Hardware/MCP33151 Eval Board/IO Expansion.SchDoc
1 Hardware/MCP33151 Eval Board/MCP33151 Eval Board.PrjPcb
1 Hardware/MCP33151 Eval Board/MCP33151 Eval Board.SchDoc
1 Hardware/MCP33151 Eval Board/Microcontroller.SchDoc
1 Hardware/MCP33151 Eval Board/Power.SchDoc
1 Hardware/MCP33151 Eval Board/Relay Drivers.SchDoc
