yunjasper/ecse478_honours_thesis/2 Firmware/DAQDevice_BoardBringUp/src/RelayDrivers.hpp

/**
 * RelayDrivers.hpp
 * 
 * Author: Jasper Yun
 */

#pragma once
#include <stdint.h>

namespace RelayDrivers {

  // function prototypes
  void init();
  void setRelayActivatedState(uint8_t channel, bool activatedState);
  bool getRelayActivatedState(uint8_t channel);
  
}
