yunjasper/ecse478_honours_thesis/2 Firmware/DAQDevice_BoardBringUp/src/BSP.hpp

/**
 * BSP.hpp
 * 
 * Board Support Package header file.
 * 
 * Author: Jasper Yun
 * 
 */

#pragma once

namespace BSP {

    void initPins();
    float readBoardTemperature();

    // analog input-related functions
    

}
