yunjasper/ecse478_honours_thesis/2 Firmware/DAQDevice_BoardBringUp/src/bringup_testing.cpp

/**
 * @file bringup_testing.cpp
 * @author Jasper Yun
 * @brief contains functions to do testing of the board's functions.
 * @version 0.1
 * 
 * 
 */


// custom libraries
#include "bringup_testing.hpp"
#include "ADCmcp33151.hpp"
#include "AnalogInputs.hpp"
#include "BSP.hpp"
#include "pinDefs.h"
#include "RelayDrivers.hpp"

// arduino libraries
#include <Arduino.h>
#include <Adafruit_MCP23008.h>
#include <string.h>
#include <stdio.h>

// private functions


void bringup_testing::init() {
    BSP::initPins();
}

void bringup_testing::blinky_onboardLED(long delayDuration, uint16_t numBlinks) {
    Serial.println("Starting blinky onboard LED test...");
    
    Adafruit_MCP23008 mcp;
    mcp.begin(IO_EXPANSION_4_I2C_ADDR);
    // set all pins as outputs
    for(uint8_t i = 0; i < 8; i++) {
        mcp.pinMode(i, OUTPUT);
    }

    if (numBlinks == 0) { // blink forever
        while (1) {
            digitalWrite(DEBUG_LED1_PIN, HIGH);
            delay(delayDuration);
            mcp.digitalWrite(6, HIGH);
            delay(delayDuration);
            mcp.digitalWrite(7, HIGH);
            delay(delayDuration);
            digitalWrite(DEBUG_LED1_PIN, LOW);
            delay(delayDuration);
            mcp.digitalWrite(6, LOW);
            delay(delayDuration);
            mcp.digitalWrite(7, LOW);
            delay(delayDuration);
        }
    }
    else {
        for (uint16_t i = 0; i < numBlinks; i++) {
            digitalWrite(DEBUG_LED1_PIN, HIGH);
            delay(delayDuration);
            digitalWrite(DEBUG_LED1_PIN, LOW);
            delay(delayDuration); 
        }
    }
}

void bringup_testing::blinky_FIOs(long delayDuration, uint16_t numBlinks) {
    Serial.println("Starting blinky onboard LED test...");
    
    uint8_t pinsArray[] = {
        FIO_1_PIN, 
        FIO_2_PIN, 
        FIO_3_PIN, 
        FIO_4_PIN, 
        FIO_5_PIN, 
        FIO_6_PIN, 
        FIO_7_PIN, 
        FIO_8_PIN, 
        FIO_9_PIN, 
        FIO_10_PIN, 
    };

    for (uint8_t i = 0; i < 10; i++) {
        pinMode(pinsArray[i], OUTPUT);
        digitalWrite(pinsArray[i], LOW);
    }

    // blink away
    if (numBlinks == 0) {
        while (1) {
            for (uint8_t i = 0; i < 10; i++) {
                digitalWrite(pinsArray[i], !digitalRead(pinsArray[i]));
                delay(delayDuration);
            }
        }
    }
    else {
        for (uint16_t i = 0; i < numBlinks; i++) {
            for (uint8_t i = 0; i < 10; i++) {
                digitalWrite(pinsArray[i], !digitalRead(pinsArray[i]));
                delay(delayDuration);
            }
        }
    }

}

void bringup_testing::blinky_DIOs(long delayDuration, uint16_t numBlinks) {
    Adafruit_MCP23008 mcp;
    mcp.begin(IO_EXPANSION_4_I2C_ADDR);

    // set all pins as outputs
    for(uint8_t i = 0; i < 8; i++) {
        mcp.pinMode(i, OUTPUT);
    }

    // blink away
    if (numBlinks == 0) {
        while (1) {
            for (uint8_t i = 0; i < 8; i++) {
                mcp.digitalWrite(i, !mcp.digitalRead(i));
                delay(delayDuration);
            }
        }
    }
    else {
        for (uint16_t i = 0; i < numBlinks; i++) {
            for (uint8_t i = 0; i < 10; i++) {
                mcp.digitalWrite(i, !mcp.digitalRead(i));
                delay(delayDuration);
            }
        }
    }

}

void bringup_testing::relays_all_toggle(long delayDuration) {

    RelayDrivers::init();
    bool state = false;

    while (1) {
        for (uint8_t channel = 1; channel <= 24; channel++) {
            RelayDrivers::setRelayActivatedState(channel,state);
        }
        state = !state;
        delay(delayDuration);
    }
}

void bringup_testing::ain_LS_SE_cycle_through(long delayDuration, uint16_t readsPerChannel, enum AnalogInputsGains gain) {
    Serial.println("Starting LS SE Cycle Through...");
    AnalogInputs ains;
    ains.init();
    ains.ls_se_ain_setGain(gain);
    char bufff[1000] = {0};
    sprintf(bufff, "LS SE GAIN MUX -- A1, A0 = %d, %d\r\n",
        digitalRead(MUX_LS_GAIN_A1),
        digitalRead(MUX_LS_GAIN_A0)
    );
    // Serial.print(bufff);

    for (uint8_t channel = 1; channel <= 24; channel++) {
        Serial.print("LS SE Channel = ");
        Serial.println(channel);

        for (uint16_t numReads = 0; numReads < readsPerChannel; numReads++) {
            float voltage = ains.ls_se_ain_readChannel(channel);
            Serial.print("\tVoltage = ");
            Serial.println(voltage);
            delay(delayDuration);

            char buf[1000] = {0};
            sprintf(buf, "LS SE AIN MUX 1 -- A2, A1, A0 = %d, %d, %d\r\n", 
                digitalRead(MUX_LS_AIN_A2),
                digitalRead(MUX_LS_AIN_A1),
                digitalRead(MUX_LS_AIN_A0)
            );
            // Serial.print(buf);
            sprintf(buf, "LS SE SEL MUX -- A1, A0 = %d, %d\r\n",
                digitalRead(MUX_LS_SE_SEL_A1),
                digitalRead(MUX_LS_SE_SEL_A0)
            );
            // Serial.print(buf);
        }
    }
    
}

void bringup_testing::ain_HS_SE_cycle_through(long delayDuration, uint16_t readsPerChannel, enum AnalogInputsGains gain) {
    Serial.println("Starting HS SE Cycle Through...");
    AnalogInputs ains;
    ains.init();
    ains.hs_se_ain_setGain(gain);
    char bufff[1000] = {0};
    sprintf(bufff, "HS SE GAIN MUX -- A1, A0 = %d, %d\r\n",
        digitalRead(MUX_HS_SE_GAIN_A1),
        digitalRead(MUX_HS_SE_GAIN_A0)
    );
    // Serial.print(bufff);

    for (uint8_t channel = 1; channel <= 8; channel++) {
        Serial.print("HS SE Channel = ");
        Serial.println(channel);

        for (uint16_t numReads = 0; numReads < readsPerChannel; numReads++) {
            float voltage = ains.hs_se_ain_readChannel(channel);
            Serial.print("\tVoltage = ");
            Serial.println(voltage);
            delay(delayDuration);

            char buf[1000] = {0};
            sprintf(buf, "HS SE AIN MUX -- A2, A1, A0 = %d, %d, %d\r\n", 
                digitalRead(MUX_HS_SE_AIN_A2),
                digitalRead(MUX_HS_SE_AIN_A1),
                digitalRead(MUX_HS_SE_AIN_A0)
            );
            // Serial.print(buf);
        }
    }
}

void bringup_testing::ain_HS_DE_cycle_through(long delayDuration, uint16_t readsPerChannel, enum AnalogInputsGains gain) {
    Serial.println("Starting HS DE Cycle Through...");
    AnalogInputs ains;
    ains.init();
    ains.hs_de_ain_setGain(gain);
    char bufff[1000] = {0};
    sprintf(bufff, "HS DE GAIN MUX -- A1, A0 = %d, %d\r\n",
        digitalRead(MUX_HS_DE_GAIN_A1),
        digitalRead(MUX_HS_DE_GAIN_A0)
    );
    // Serial.print(bufff);

    for (uint8_t channel = 1; channel <= 4; channel++) {
        Serial.print("HS DE Channel = ");
        Serial.println(channel);

        for (uint16_t numReads = 0; numReads < readsPerChannel; numReads++) {
            float voltage = ains.hs_de_ain_readChannel(channel);
            Serial.print("\tVoltage = ");
            Serial.println(voltage);
            delay(delayDuration);

            char buf[1000] = {0};
            sprintf(buf, "HS DE AIN MUX -- A1, A0 = %d, %d\r\n", 
                digitalRead(MUX_HS_DE_AIN_A1),
                digitalRead(MUX_HS_DE_AIN_A0)
            );
            // Serial.print(buf);
        }
    }
}
