yunjasper/ecse478_honours_thesis/(commit log)

2022-09-21 initial commit, add files
    [Hardware Design Calculations.xlsx, Requirements.xlsx, Software Design Calculations.xlsx]
2022-11-08 eval board first-pass layout done, i didn't do small commits :(
    [ADC.SchDoc, Analog - High Speed DE.SchDoc, Analog - High Speed SE.SchDoc, Analog - Low Speed SE.SchDoc, Breadboard Prototyping Schematic.SchDoc, Communication.SchDoc, Connectors.SchDoc, Cover.SchDoc]
2022-11-08 update notes and add documentation
    [Analog - High Speed DE.SchDoc, Analog - Low Speed SE.SchDoc, IO Expansion.SchDoc, Microcontroller.SchDoc]
2022-11-08 Add mounting holes and silkscreen
    [Connectors.SchDoc, MCP33151 Eval Board.PrjPcb]
2022-11-08 add diagram to tolerances. add RC filter after boosts. sim with PWL
    [Hardware Design Calculations.xlsx, Power.SchDoc, thrust_points.csv]
2022-11-08 passed DRC (635 total violations)
    [thrust_points.csv]
2022-11-09 added jumper for adc OV/UV. made L3 fully GND plane. passed DRC
    [Analog - High Speed DE.SchDoc, Analog - Low Speed SE.SchDoc, MCP33151 Eval Board.PrjPcb]
2022-11-09 moved DE AIN gain stage up for more space between analog and digital
    [Microcontroller.SchDoc]
2022-11-09 SE AIN spacing to 18mil, length matched SPI
    [Microcontroller.SchDoc]
2022-11-10 add series termination to nCS and mux select. doing checklists
    [Analog - High Speed DE.SchDoc, Debug.SchDoc, Hardware Design Calculations.xlsx, IO Expansion.SchDoc, MCP33151 Eval Board Schematic Symbol and Footprint Checks.xlsx, MCP33151 Eval Board.PrjPcb, Microcontroller.SchDoc, Power.SchDoc]
2022-11-11 finished schematic and layout checklists. passed DRC
    [IO Expansion.SchDoc, MCP33151 Eval Board Schematic Symbol and Footprint Checks.xlsx, MCP33151 Eval Board.PrjPcb, Power.SchDoc]
2022-11-11 exported gerbers and nc drill files
    [MCP33151 Eval Board.GBL, MCP33151 Eval Board.GBO, MCP33151 Eval Board.GBP, MCP33151 Eval Board.GBS, MCP33151 Eval Board.GTL, MCP33151 Eval Board.GTO, MCP33151 Eval Board.GTP, MCP33151 Eval Board.GTS]
2022-11-11 add draftsman doc and export
    [MCP33151 Eval Board.PrjPcb]
2022-11-23 add bringup files. pushing all changes
    [ADC.SchDoc, Analog - High Speed DE.SchDoc, Analog - Low Speed SE.SchDoc, BOM - MCP33151 Eval Board.xlsx, Board Bringup Measurements.xlsx, Connectors.SchDoc, Cover.SchDoc, Debug.SchDoc]
2022-11-25 LS SE channels working, committing all changes
    [Board Bringup Measurements.xlsx, Breadboard Prototyping Schematic.SchDoc, Hardware Design Calculations.xlsx]
2022-11-29 continuing testing, committing changes
    [Board Bringup Measurements.xlsx, Hardware Design Calculations.xlsx]
2022-11-30 add temperature sensor code. refactor into BSP
    [Board Bringup Measurements.xlsx]
2023-01-05 copy eval board to daq device schematics. updated power budget. continued design for daq device
    [ADC.SchDoc, Analog - High Speed DE.SchDoc, Analog - High Speed SE.SchDoc, Analog - Low Speed SE.SchDoc, Connectors - Analog.SchDoc, Connectors - Digital.SchDoc, Connectors.SchDoc, Cover.SchDoc]
2023-01-07 first pass layout done
    [ADC.SchDoc, Analog - High Speed DE.SchDoc, Analog - High Speed SE.SchDoc, Analog - Low Speed SE.SchDoc, Connectors - Analog.SchDoc, Connectors - Digital.SchDoc, Debug.SchDoc, ECSE478 - DAQ Device.PrjPcb]
2023-01-07 increased clearance for connectors, passed drc
2023-01-07 add esd protection
    [Analog - High Speed DE.SchDoc, Analog - High Speed SE.SchDoc, Analog - Low Speed SE.SchDoc, Microcontroller.SchDoc, Power.SchDoc]
2023-01-08 added voltage divider for AINs, passed DRC
    [Analog - High Speed DE.SchDoc, Analog - High Speed SE.SchDoc, Analog - Low Speed SE.SchDoc, Communication.SchDoc, Connectors - Analog.SchDoc, Connectors - Digital.SchDoc, Connectors.SchDoc, Cover.SchDoc]
2023-01-14 board ordered
    [Analog - Low Speed SE.SchDoc, Connectors - Digital.SchDoc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]
2023-02-13 starting firmware for DAQ device by refactoring eval board code
    [Bill of Materials-ECSE478 - DAQ Device(Production).xlsx, Bill of Materials-ECSE478 - DAQ Device(Production)_no_footprints.xlsx, Board Bringup Measurements.xlsx, DAQ device board bringup.xlsx, ECSE478 - DAQ Device.PrjPcb, Hardware Design Calculations.xlsx]
2023-02-13 added relay drivers abstraction
2023-02-13 refactored into src folder, blinky with onboard LED working
2023-02-13 relay drivers working
2023-02-14 LS SE AIN switching working
2023-02-17 add misc hardware changes
    [Analog Circuits.SchDoc, DB Connectors.SchDoc, ECSE478 - Demo Expansion Board.PrjPcb, Power.SchDoc, Relays and Digital.SchDoc]
2023-04-13 cleaned up repo, delete unnecessary files/data
    [Analog - Low Speed SE.SchDoc, Analog Circuits.SchDoc, BOM - MCP33151 Eval Board.xlsx, Bill of Materials-ECSE478 - DAQ Device(Production).xlsx, Bill of Materials-ECSE478 - DAQ Device(Production)_no_footprints.xlsx, Bill of Materials-ECSE478 - DAQ Device.xlsx, Bill of Materials-ECSE478 - DAQ Device_report_cost_analysis.xlsx, Board Bringup Measurements.xlsx]
